victovats/chipalooza3-ldo-gf180/simulations/results/summary.md

# Simulation results (schematic, pre-layout)

Generated by `simulations/run_sims.py`. Typical corner, 27 C, VIN = 5.0 V, VREF = 1.2 V,
EN = 3.3 V (harness logic level), CL = 2 pF, unless noted.

| Parameter | Spec | Simulated | Result | Testbench |
|---|---|---|---|---|
| Output voltage (5 mA) | 3.201 - 3.399 V | 3.3092 V | PASS | tb_load_reg |
| Dropout (10 mA) | <= 300 mV | 152 mV | PASS | tb_dropout |
| Quiescent current (no load) | <= 100 uA | 60.0 uA | PASS | tb_iq |
| Line regulation (4.5-5.5 V, 5 mA) | <= 1.0 % | 0.042 % | PASS | tb_line_reg |
| Load regulation (0-10 mA) | <= 1.0 % | 0.269 % | PASS | tb_load_reg |
| PSRR (100 Hz, 5 mA) | >= 40 dB | 59.0 dB | PASS | tb_psrr |
| PSRR (10 kHz / 1 MHz) | - | 43.9 / 5.2 dB | info | tb_psrr |
| Load step 0->10 mA, 1 us | - | -212 / +313 mV | info | tb_tran_load |
| Line step 5.0->4.5 V, 1 us | - | -54 / +52 mV | info | tb_tran_line |
| EN off -> VOUT | 0 V | 0.00 mV | PASS | tb_en |
| EN turn-on time (to 3.2 V) | - | 1.66 us | info | tb_en |
| EN switching threshold | 3.3 V logic | 1.39 / 1.58 V (VIN 4.5 / 5.5) | PASS | tb_en_dc |
| Shutdown current (EN = 0) | - | 0.19 nA | info | tb_iq |
| Test buffer FB_BUF (FB - FB_BUF) | follows FB | 0.442 V (0.763 V below FB = 1.206 V) | info | tb_iq |
| Test buffer EAOUT_BUF (EAOUT - EAOUT_BUF) | follows EAOUT | 2.908 V (1.331 V below EAOUT = 4.239 V) | info | tb_iq |

line regulation load regulation
dropout PSRR
load transient line transient
EN transient EN threshold
quiescent and shutdown current

## Process corners x temperature (VIN = 5.0 V)

MOS corners tt/ff/ss/fs/sf x poly-resistor and MIM-capacitor corners typical/ff/ss x -40/27/110 C.
Each column uses the same testbench and load as the typical table above: VOUT at a 5 mA ideal current
sink (tb_load_reg), Iq and off current with no load (tb_iq), line reg at 5 mA, load reg 0-10 mA,
dropout at 10 mA, PSRR at 5 mA.

| MOS corner | R/C corner | Temp (C) | VOUT @5 mA (V) | Iq (uA) | Line reg (%) | Load reg (%) | Dropout @10 mA (mV) | PSRR @100 Hz (dB) | Off current, EN = 0 (nA) |
|---|---|---|---|---|---|---|---|---|---|
| typical | typical | -40 | 3.3086  | 55.3  | 0.033  | 0.207  | 107  | 61.1  | 0.18 |
| typical | typical | 27 | 3.3092  | 60.0  | 0.042  | 0.269  | 152  | 59.0  | 0.19 |
| typical | typical | 110 | 3.3097  | 65.0  | 0.050  | 0.378  | 207  | 57.2  | 0.39 |
| typical | ff | -40 | 3.3089  | 67.8  | 0.039  | 0.215  | 107  | 59.6  | 0.18 |
| typical | ff | 27 | 3.3099  | 73.6  | 0.048  | 0.285  | 152  | 57.6  | 0.19 |
| typical | ff | 110 | 3.3108  | 79.7  | 0.057  | 0.420  | 206  | 56.0  | 0.39 |
| typical | ss | -40 | 3.3084  | 46.9  | 0.029  | 0.202  | 108  | 62.5  | 0.18 |
| typical | ss | 27 | 3.3087  | 50.9  | 0.037  | 0.260  | 153  | 60.2  | 0.19 |
| typical | ss | 110 | 3.3090  | 55.1  | 0.045  | 0.354  | 208  | 58.4  | 0.39 |
| ff | typical | -40 | 3.3080  | 60.7  | 0.045  | 0.203  | 83  | 58.2  | 0.20 |
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
| sf | ss | -40 | 3.3078  | 45.3  | 0.048  | 0.206  | 88  | 57.8  | 0.19 |
| sf | ss | 27 | 3.3081  | 48.9  | 0.058  | 0.270  | 123  | 56.0  | 0.19 |
| sf | ss | 110 | 3.3083  | 52.8  | 0.070  | 0.393  | 168  | 54.4  | 0.82 |
