victovats/chipalooza3-ldo-gf180/simulations/results_v2_pex_rc/stability.md

# Regulation-loop stability (post-layout, extracted RC netlist)

Generated by `simulations/stability.py`. Loop broken at the MIN1 gate; T = -v(FB)/v(FBG).
Swept: load 0-10 mA, MOS corners tt/ff/ss/fs/sf, -40/27/110 C, output capacitance 2 pF and 50 pF.

| CL | worst-case PM | at | lowest UGF | highest UGF | min GM |
|---|---|---|---|---|---|
| 2 pF | 64.4 deg | fs, 110 C, 0 mA | 1.27 MHz | 1.88 MHz | 12.6 dB |
| 50 pF | 26.1 deg | fs, 110 C, 0 mA | 0.75 MHz | 1.88 MHz | 10.7 dB |

Typical corner, 27 C:

| Load | CL | T(dc) | UGF | PM | GM |
|---|---|---|---|---|---|
| 0 mA | 2 pF | 69.0 dB | 1.53 MHz | 67.6 deg | 13.6 dB |
| 0.001 mA | 2 pF | 69.5 dB | 1.53 MHz | 68.6 deg | 14.2 dB |
| 0.01 mA | 2 pF | 72.0 dB | 1.55 MHz | 74.0 deg | 17.2 dB |
| 0.1 mA | 2 pF | 76.7 dB | 1.57 MHz | 80.8 deg | 25.7 dB |
| 1 mA | 2 pF | 77.1 dB | 1.56 MHz | 82.5 deg | 36.2 dB |
| 5 mA | 2 pF | 74.8 dB | 1.54 MHz | 83.0 deg | inf dB |
| 10 mA | 2 pF | 74.3 dB | 1.52 MHz | 83.5 deg | inf dB |
| 0 mA | 50 pF | 69.0 dB | 0.90 MHz | 28.7 deg | 12.2 dB |
| 0.001 mA | 50 pF | 69.5 dB | 0.93 MHz | 29.9 deg | 12.6 dB |
| 0.01 mA | 50 pF | 72.0 dB | 1.11 MHz | 38.5 deg | 13.6 dB |
| 0.1 mA | 50 pF | 76.7 dB | 1.49 MHz | 64.5 deg | 17.5 dB |
| 1 mA | 50 pF | 77.1 dB | 1.56 MHz | 78.0 deg | 22.3 dB |
| 5 mA | 50 pF | 74.8 dB | 1.54 MHz | 80.7 deg | 25.4 dB |
| 10 mA | 50 pF | 74.3 dB | 1.52 MHz | 81.8 deg | 28.7 dB |

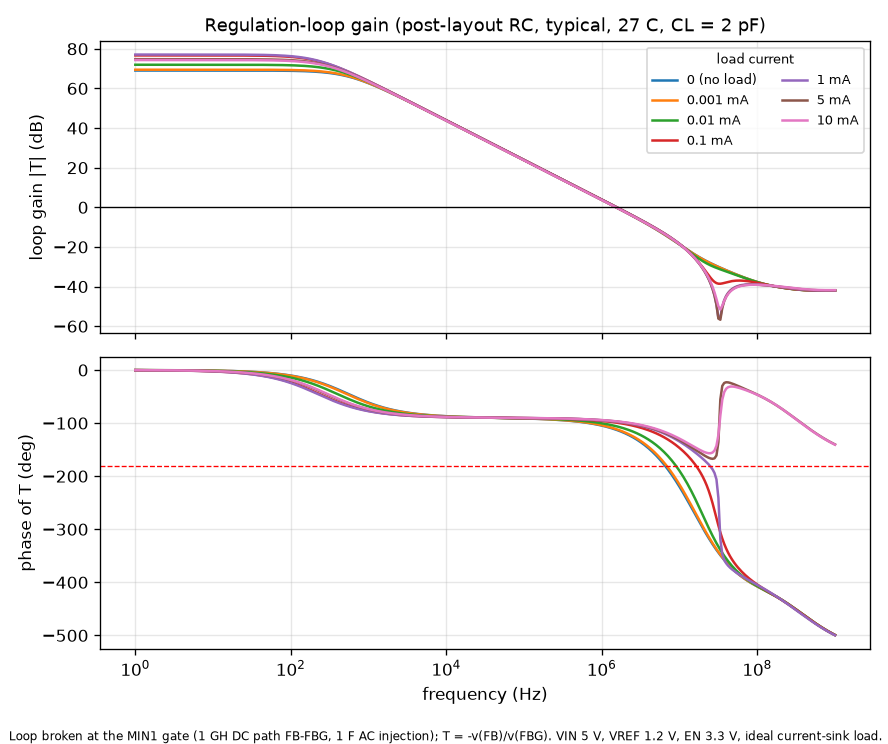
[picture p53: simulations/results_v2_pex_rc/stability.png]
loop gain
