victovats/chipalooza3-ldo-gf180/simulations/results_v2_pex_rc/summary.md

# Simulation results (post-layout, extracted RC netlist)

Generated by `simulations/run_sims.py`. Typical corner, 27 C, VIN = 5.0 V, VREF = 1.2 V,
EN = 3.3 V (harness logic level), CL = 2 pF, unless noted.

| Parameter | Spec | Simulated | Result | Testbench |
|---|---|---|---|---|
| Output voltage (5 mA) | 3.201 - 3.399 V | 3.3093 V | PASS | tb_load_reg |
| Dropout (10 mA) | <= 300 mV | 162 mV | PASS | tb_dropout |
| Quiescent current (no load) | <= 100 uA | 59.8 uA | PASS | tb_iq |
| Line regulation (4.5-5.5 V, 5 mA) | <= 1.0 % | 0.042 % | PASS | tb_line_reg |
| Load regulation (0-10 mA) | <= 1.0 % | 0.271 % | PASS | tb_load_reg |
| PSRR (100 Hz, 5 mA) | >= 40 dB | 59.0 dB | PASS | tb_psrr |
| PSRR (10 kHz / 1 MHz) | - | 43.4 / 4.5 dB | info | tb_psrr |
| Load step 0->10 mA, 1 us | - | -249 / +343 mV | info | tb_tran_load |
| Line step 5.0->4.5 V, 1 us | - | -58 / +56 mV | info | tb_tran_line |
| EN off -> VOUT | 0 V | 0.00 mV | PASS | tb_en |
| EN turn-on time (to 3.2 V) | - | 1.74 us | info | tb_en |
| EN switching threshold | 3.3 V logic | 1.39 / 1.59 V (VIN 4.5 / 5.5) | PASS | tb_en_dc |
| Shutdown current (EN = 0) | - | 1.27 nA | info | tb_iq |
| Test buffer FB_BUF (FB - FB_BUF) | follows FB | 0.442 V (0.764 V below FB = 1.206 V) | info | tb_iq |
| Test buffer EAOUT_BUF (EAOUT - EAOUT_BUF) | follows EAOUT | 2.908 V (1.331 V below EAOUT = 4.239 V) | info | tb_iq |

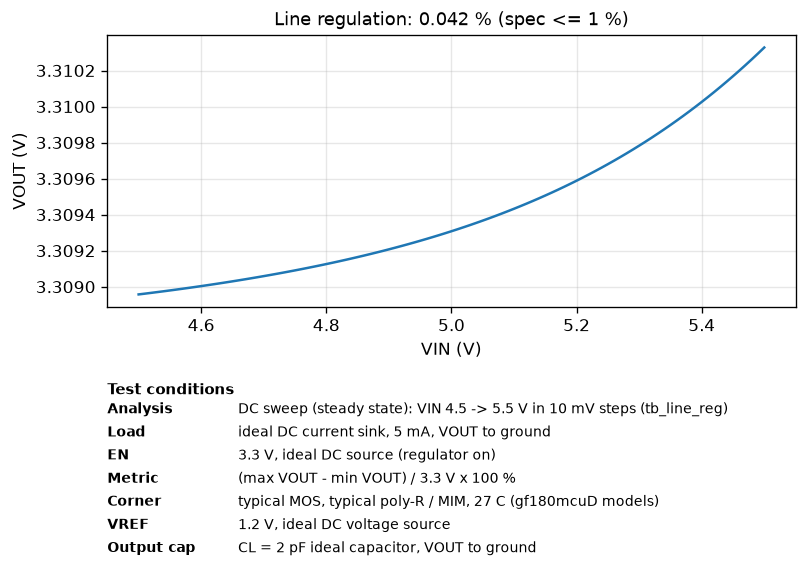
[picture p54: simulations/results_v2_pex_rc/line_reg.png]
line regulation
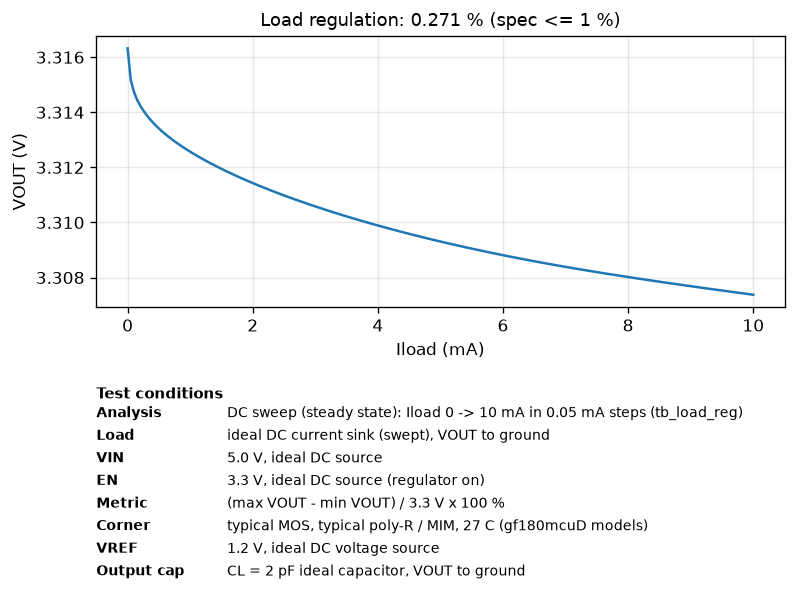
[picture p55: simulations/results_v2_pex_rc/load_reg.png]
load regulation
 
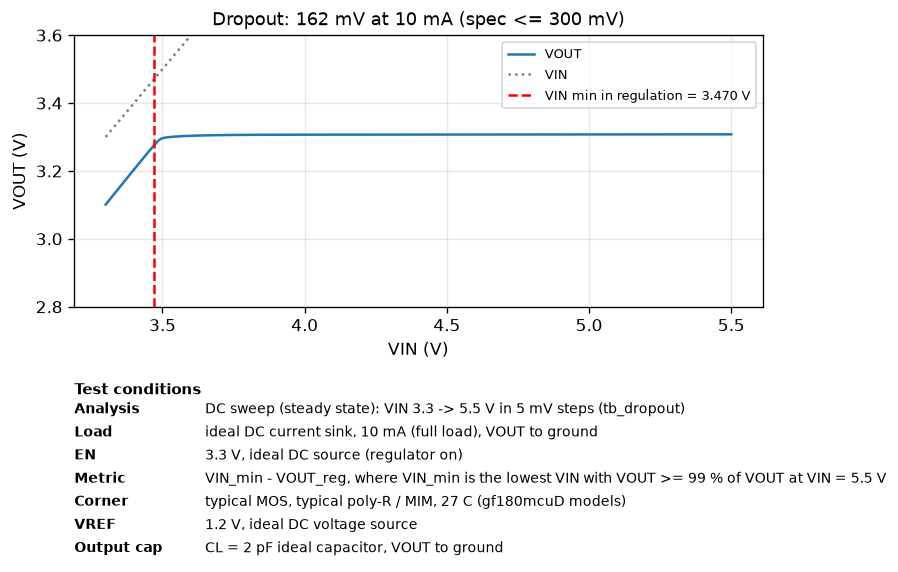
[picture p56: simulations/results_v2_pex_rc/dropout.png]
dropout
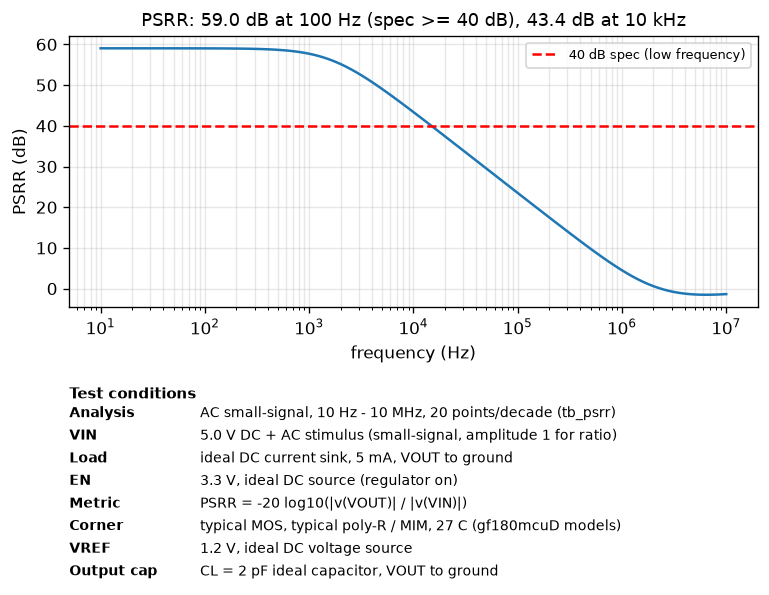
[picture p57: simulations/results_v2_pex_rc/psrr.png]
PSRR
 
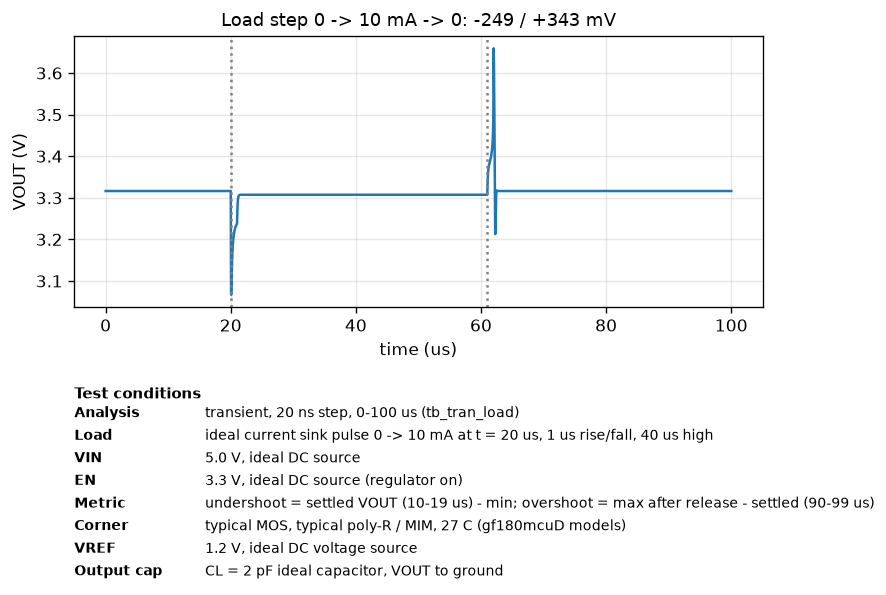
[picture p58: simulations/results_v2_pex_rc/tran_load.png]
load transient
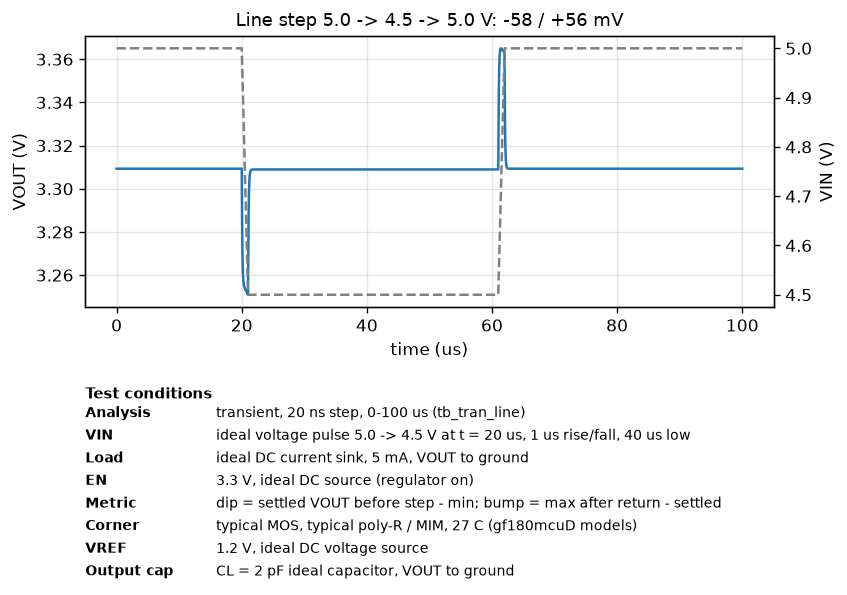
[picture p59: simulations/results_v2_pex_rc/tran_line.png]
line transient
 
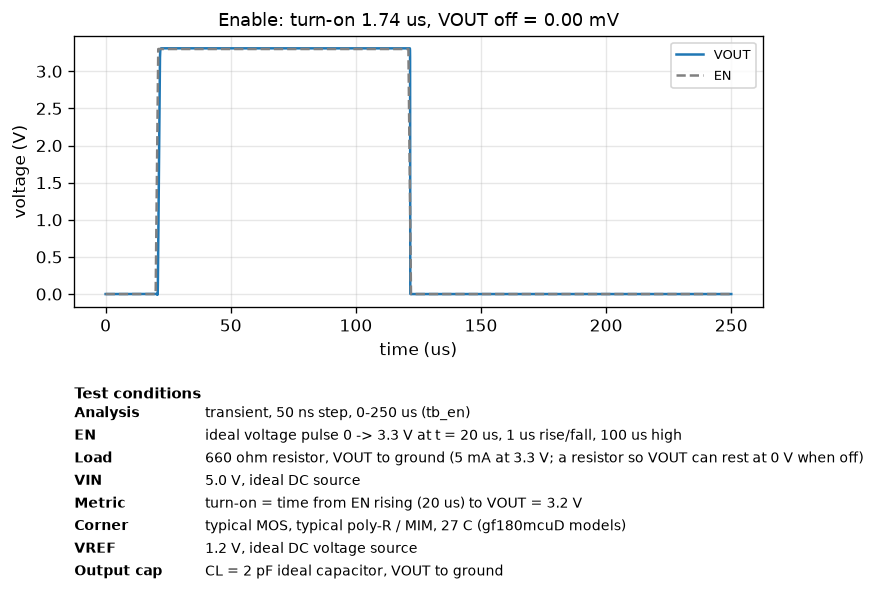
[picture p60: simulations/results_v2_pex_rc/en.png]
EN transient
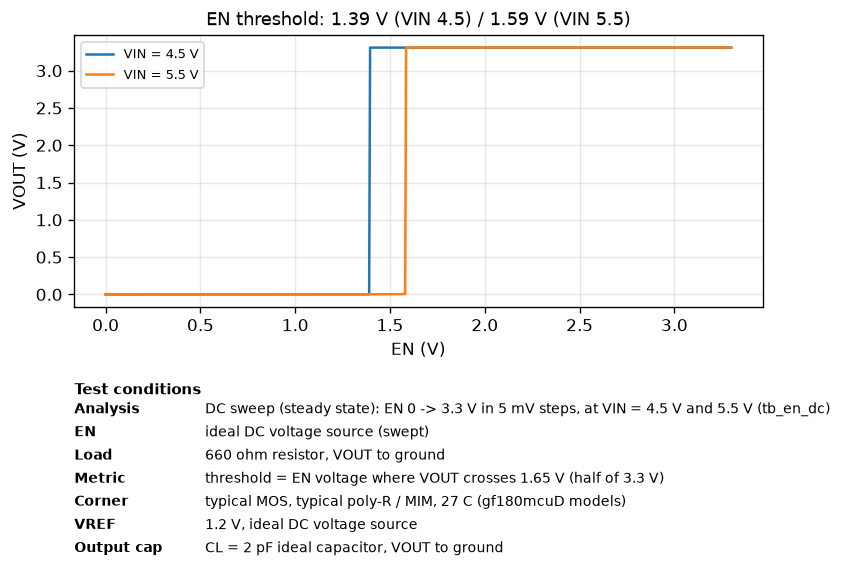
[picture p61: simulations/results_v2_pex_rc/en_dc.png]
EN threshold
 
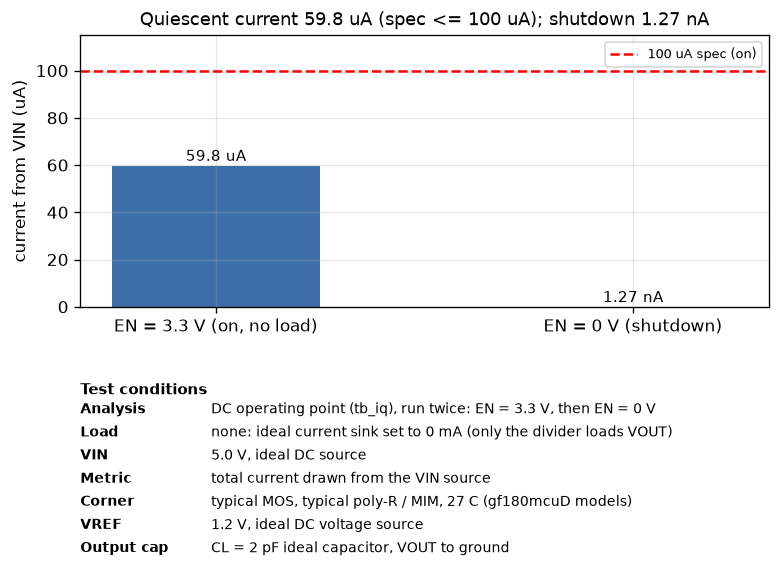
[picture p62: simulations/results_v2_pex_rc/iq.png]
quiescent and shutdown current


## Process corners x temperature (VIN = 5.0 V)

MOS corners tt/ff/ss/fs/sf x poly-resistor and MIM-capacitor corners typical/ff/ss x -40/27/110 C.
Each column uses the same testbench and load as the typical table above: VOUT at a 5 mA ideal current
sink (tb_load_reg), Iq and off current with no load (tb_iq), line reg at 5 mA, load reg 0-10 mA,
dropout at 10 mA, PSRR at 5 mA.

| MOS corner | R/C corner | Temp (C) | VOUT @5 mA (V) | Iq (uA) | Line reg (%) | Load reg (%) | Dropout @10 mA (mV) | PSRR @100 Hz (dB) | Off current, EN = 0 (nA) |
|---|---|---|---|---|---|---|---|---|---|
| typical | typical | -40 | 3.3092  | 55.0  | 0.033  | 0.208  | 117  | 61.2  | 1.27 |
| typical | typical | 27 | 3.3093  | 59.8  | 0.042  | 0.271  | 162  | 59.0  | 1.27 |
| typical | typical | 110 | 3.3097  | 64.8  | 0.050  | 0.382  | 217  | 57.3  | 1.50 |
| typical | ff | -40 | 3.3098  | 67.4  | 0.039  | 0.216  | 121  | 59.7  | 1.27 |
| typical | ff | 27 | 3.3103  | 73.3  | 0.048  | 0.287  | 166  | 57.7  | 1.27 |
| typical | ff | 110 | 3.3110  | 79.3  | 0.057  | 0.427  | 216  | 56.0  | 1.50 |
| typical | ss | -40 | 3.3087  | 46.7  | 0.029  | 0.203  | 117  | 62.5  | 1.27 |
| typical | ss | 27 | 3.3087  | 50.7  | 0.037  | 0.261  | 163  | 60.2  | 1.27 |
| typical | ss | 110 | 3.3088  | 54.9  | 0.044  | 0.357  | 218  | 58.4  | 1.50 |
| ff | typical | -40 | 3.3085  | 60.5  | 0.045  | 0.204  | 97  | 58.4  | 1.29 |
| ff | typical | 27 | 3.3088  | 65.6  | 0.056  | 0.277  | 132  | 56.4  | 1.31 |
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
| sf | ss | -40 | 3.3081  | 45.1  | 0.047  | 0.207  | 98  | 57.9  | 1.28 |
| sf | ss | 27 | 3.3080  | 48.7  | 0.058  | 0.271  | 138  | 56.1  | 1.28 |
| sf | ss | 110 | 3.3081  | 52.6  | 0.069  | 0.396  | 183  | 54.5  | 1.92 |
