victovats/chipalooza3-ldo-gf180/layout/lvs/ldo_v2_lvs.spice

.subckt ldo_v2 VIN VREF EN VOUT FB_BUF EAOUT_BUF VSS
X0 VIN EAOUT EAOUT_BUF VSS nfet_05v0 ad=3p pd=11.2u as=3p ps=11.2u w=5u l=0.6u
X1 VOUT EAOUT VIN VIN pfet_06v0 ad=0.84p pd=3.56u as=0.84p ps=3.56u w=3u l=0.55u
X2 VOUT EAOUT VIN VIN pfet_06v0 ad=0.84p pd=3.56u as=0.84p ps=3.56u w=3u l=0.55u
X3 VOUT EAOUT VIN VIN pfet_06v0 ad=0.84p pd=3.56u as=0.84p ps=3.56u w=3u l=0.55u
X4 VIN EAOUT VOUT VIN pfet_06v0 ad=0.84p pd=3.56u as=0.84p ps=3.56u w=3u l=0.55u
X5 VIN EAOUT VOUT VIN pfet_06v0 ad=0.84p pd=3.56u as=0.84p ps=3.56u w=3u l=0.55u
X6 VIN EAOUT VOUT VIN pfet_06v0 ad=0.84p pd=3.56u as=0.84p ps=3.56u w=3u l=0.55u
X7 VOUT EAOUT VIN VIN pfet_06v0 ad=0.84p pd=3.56u as=0.84p ps=3.56u w=3u l=0.55u
X8 VOUT EAOUT VIN VIN pfet_06v0 ad=0.84p pd=3.56u as=0.84p ps=3.56u w=3u l=0.55u
X9 VOUT EAOUT VIN VIN pfet_06v0 ad=0.84p pd=3.56u as=0.84p ps=3.56u w=3u l=0.55u
X10 VIN EAOUT VOUT VIN pfet_06v0 ad=0.84p pd=3.56u as=0.84p ps=3.56u w=3u l=0.55u
X11 VIN EAOUT VOUT VIN pfet_06v0 ad=0.84p pd=3.56u as=0.84p ps=3.56u w=3u l=0.55u
X12 VIN EAOUT VOUT VIN pfet_06v0 ad=0.84p pd=3.56u as=0.84p ps=3.56u w=3u l=0.55u
X13 VIN EAOUT VOUT VIN pfet_06v0 ad=0.84p pd=3.56u as=0.84p ps=3.56u w=3u l=0.55u
X14 VOUT EAOUT VIN VIN pfet_06v0 ad=0.84p pd=3.56u as=0.84p ps=3.56u w=3u l=0.55u
X15 VOUT EAOUT VIN VIN pfet_06v0 ad=0.84p pd=3.56u as=0.84p ps=3.56u w=3u l=0.55u
X16 VIN EAOUT VOUT VIN pfet_06v0 ad=0.84p pd=3.56u as=0.84p ps=3.56u w=3u l=0.55u
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
X213 v2_nmos_core/a_n768_3216# VREF EAOUT VSS nfet_06v0 ad=1.4p pd=5.56u as=1.4p ps=5.56u w=5u l=3u
X214 EAOUT VREF v2_nmos_core/a_n768_3216# VSS nfet_06v0 ad=1.4p pd=5.56u as=1.4p ps=5.56u w=5u l=3u
X216 EAOUT VREF v2_nmos_core/a_n768_3216# VSS nfet_06v0 ad=1.4p pd=5.56u as=1.4p ps=5.56u w=5u l=3u
X217 VSS IREF v2_nmos_core/a_n768_3216# VSS nfet_05v0 ad=0.35p pd=1.81u as=0.35p ps=1.81u w=1.25u l=0.6u
X218 v2_nmos_core/a_n768_3216# IREF VSS VSS nfet_05v0 ad=0.35p pd=1.81u as=0.35p ps=1.81u w=1.25u l=0.6u
X219 v2_nmos_core/a_n768_3216# FB v2_pmos_core/EAREF VSS nfet_06v0 ad=1.4p pd=5.56u as=1.4p ps=5.56u w=5u l=3u
X220 IREF IREF VSS VSS nfet_05v0 ad=0.35p pd=1.81u as=0.35p ps=1.81u w=1.25u l=0.6u
X221 v2_pmos_core/EAREF FB v2_nmos_core/a_n768_3216# VSS nfet_06v0 ad=1.4p pd=5.56u as=1.4p ps=5.56u w=5u l=3u
X222 VSS IREF IREF VSS nfet_05v0 ad=0.35p pd=1.81u as=0.35p ps=1.81u w=1.25u l=0.6u
X225 VSS EN v2_pmos_core/ENB_5V VSS nfet_06v0 ad=0.3p pd=2.2u as=0.3p ps=2.2u w=0.5u l=5u
X226 VSS IREF v2_nmos_core/a_n768_3216# VSS nfet_05v0 ad=0.35p pd=1.81u as=0.35p ps=1.81u w=1.25u l=0.6u
X227 VSS IREF IREF VSS nfet_05v0 ad=0.35p pd=1.81u as=0.35p ps=1.81u w=1.25u l=0.6u
X231 v2_nmos_core/a_n768_3216# FB v2_pmos_core/EAREF VSS nfet_06v0 ad=1.4p pd=5.56u as=1.4p ps=5.56u w=5u l=3u
X234 VSS v2_pmos_core/ENB_5V VOUT VSS nfet_05v0 ad=3p pd=11.2u as=3p ps=11.2u w=5u l=0.6u
X237 IREF IREF VSS VSS nfet_05v0 ad=0.35p pd=1.81u as=0.35p ps=1.81u w=1.25u l=0.6u
X238 v2_nmos_core/a_n768_3216# IREF VSS VSS nfet_05v0 ad=0.35p pd=1.81u as=0.35p ps=1.81u w=1.25u l=0.6u
X239 v2_pmos_core/EAREF FB v2_nmos_core/a_n768_3216# VSS nfet_06v0 ad=1.4p pd=5.56u as=1.4p ps=5.56u w=5u l=3u
X242 v2_nmos_core/a_n768_3216# VREF EAOUT VSS nfet_06v0 ad=1.4p pd=5.56u as=1.4p ps=5.56u w=5u l=3u
X243 R1R2/m1_n2438_4985# R1R2/m1_n1958_n5053# VSS ppolyf_u_1k_6p0 r_width=2u r_length=49.33u
X244 R1R2/m1_n998_4985# R1R2/m1_n38_n5053# VSS ppolyf_u_1k_6p0 r_width=2u r_length=49.33u
X245 R1R2/m1_n1478_4985# R1R2/m1_n518_n5053# VSS ppolyf_u_1k_6p0 r_width=2u r_length=49.33u
X246 R1R2/m1_n998_4985# R1R2/m1_n1958_n5053# VSS ppolyf_u_1k_6p0 r_width=2u r_length=49.33u
X247 R1R2/m1_n1478_4985# VSS VSS ppolyf_u_1k_6p0 r_width=2u r_length=49.33u
X250 R1R2/m1_n2438_4985# FB VSS ppolyf_u_1k_6p0 r_width=2u r_length=49.33u
X251 VOUT R1R2/m1_1882_n5053# VSS ppolyf_u_1k_6p0 r_width=2u r_length=49.33u
X252 R1R2/m1_442_4985# FB VSS ppolyf_u_1k_6p0 r_width=2u r_length=49.33u
X253 R1R2/m1_922_4985# R1R2/m1_1882_n5053# VSS ppolyf_u_1k_6p0 r_width=2u r_length=49.33u
X254 R1R2/m1_442_4985# R1R2/m1_n518_n5053# VSS ppolyf_u_1k_6p0 r_width=2u r_length=49.33u
X255 R1R2/m1_922_4985# R1R2/m1_n38_n5053# VSS ppolyf_u_1k_6p0 r_width=2u r_length=49.33u
X256 VIN_BIAS m1_704_5244# VSS ppolyf_u_1k_6p0 r_width=1u r_length=1.94384m
X257 m1_704_5244# v2_pmos_core/ENB_5V VSS VSS nfet_05v0 ad=0.6p pd=3.2u as=0.6p ps=3.2u w=1u l=0.6u
X258 v2_pmos_core/a_n2200_394# v2_pmos_core/EAREF v2_pmos_core/EAREF VIN pfet_06v0 ad=0.35p pd=1.81u as=0.35p ps=1.81u w=1.25u l=0.55u
X260 VIN VSS v2_pmos_core/ENB_5V VIN pfet_06v0 ad=0.6p pd=3.2u as=0.6p ps=3.2u w=1u l=40u
X262 v2_pmos_core/a_n2200_1734# v2_pmos_core/EAREF EAOUT VIN pfet_06v0 ad=0.35p pd=1.81u as=0.35p ps=1.81u w=1.25u l=0.55u
X263 v2_pmos_core/a_n2200_1734# v2_pmos_core/a_n2200_394# VIN VIN pfet_06v0 ad=0.7p pd=3.06u as=0.7p ps=3.06u w=2.5u l=3u
X264 v2_pmos_core/a_n2200_394# v2_pmos_core/a_n2200_394# VIN VIN pfet_06v0 ad=0.7p pd=3.06u as=0.7p ps=3.06u w=2.5u l=3u
X265 VIN v2_pmos_core/a_n2200_394# v2_pmos_core/a_n2200_394# VIN pfet_06v0 ad=0.7p pd=3.06u as=0.7p ps=3.06u w=2.5u l=3u
X267 v2_pmos_core/a_n2200_1734# v2_pmos_core/a_n2200_394# VIN VIN pfet_06v0 ad=0.7p pd=3.06u as=0.7p ps=3.06u w=2.5u l=3u
X268 VIN v2_pmos_core/a_n2200_394# v2_pmos_core/a_n2200_394# VIN pfet_06v0 ad=0.7p pd=3.06u as=0.7p ps=3.06u w=2.5u l=3u
X269 v2_pmos_core/a_n2200_1734# v2_pmos_core/EAREF EAOUT VIN pfet_06v0 ad=0.35p pd=1.81u as=0.35p ps=1.81u w=1.25u l=0.55u
X270 v2_pmos_core/EAREF v2_pmos_core/EAREF v2_pmos_core/a_n2200_394# VIN pfet_06v0 ad=0.35p pd=1.81u as=0.35p ps=1.81u w=1.25u l=0.55u
X271 VIN v2_pmos_core/EN_5V EAOUT VIN pfet_06v0 ad=3p pd=11.2u as=3p ps=11.2u w=5u l=0.6u
X272 v2_pmos_core/a_n2200_394# v2_pmos_core/a_n2200_394# VIN VIN pfet_06v0 ad=0.7p pd=3.06u as=0.7p ps=3.06u w=2.5u l=3u
X273 EAOUT v2_pmos_core/EAREF v2_pmos_core/a_n2200_1734# VIN pfet_06v0 ad=0.35p pd=1.81u as=0.35p ps=1.81u w=1.25u l=0.55u
X277 VIN_BIAS v2_pmos_core/ENB_5V VIN VIN pfet_06v0 ad=1.4p pd=5.56u as=3p ps=11.2u w=5u l=0.6u
X278 VIN v2_pmos_core/a_n2200_394# v2_pmos_core/a_n2200_1734# VIN pfet_06v0 ad=0.7p pd=3.06u as=0.7p ps=3.06u w=2.5u l=3u
X279 v2_pmos_core/EAREF v2_pmos_core/EAREF v2_pmos_core/a_n2200_394# VIN pfet_06v0 ad=0.35p pd=1.81u as=0.35p ps=1.81u w=1.25u l=0.55u
X281 VIN v2_pmos_core/ENB_5V v2_pmos_core/EN_5V VIN pfet_06v0 ad=3p pd=11.2u as=3p ps=11.2u w=5u l=0.6u
X285 EAOUT v2_pmos_core/EAREF v2_pmos_core/a_n2200_1734# VIN pfet_06v0 ad=0.35p pd=1.81u as=0.35p ps=1.81u w=1.25u l=0.55u
X288 VIN v2_pmos_core/ENB_5V VIN_BIAS VIN pfet_06v0 ad=3p pd=11.2u as=1.4p ps=5.56u w=5u l=0.6u
X290 VIN v2_pmos_core/a_n2200_394# v2_pmos_core/a_n2200_1734# VIN pfet_06v0 ad=0.7p pd=3.06u as=0.7p ps=3.06u w=2.5u l=3u
X291 v2_pmos_core/a_n2200_394# v2_pmos_core/EAREF v2_pmos_core/EAREF VIN pfet_06v0 ad=0.35p pd=1.81u as=0.35p ps=1.81u w=1.25u l=0.55u
X294 EAOUT_BUF m1_704_5244# VSS VSS nfet_05v0 ad=1.5p pd=6.2u as=1.5p ps=6.2u w=2.5u l=0.6u
X295 m1_704_5244# m1_704_5244# VSS VSS nfet_05v0 ad=1.5p pd=6.2u as=1.5p ps=6.2u w=2.5u l=0.6u
X296 EAOUT_BUF m1_704_5244# VSS VSS nfet_05v0 ad=1.5p pd=6.2u as=1.5p ps=6.2u w=2.5u l=0.6u
X298 FB_BUF m1_704_5244# VSS VSS nfet_05v0 ad=1.5p pd=6.2u as=1.5p ps=6.2u w=2.5u l=0.6u
X299 m1_704_5244# m1_704_5244# VSS VSS nfet_05v0 ad=1.5p pd=6.2u as=1.5p ps=6.2u w=2.5u l=0.6u
X300 FB_BUF m1_704_5244# VSS VSS nfet_05v0 ad=1.5p pd=6.2u as=1.5p ps=6.2u w=2.5u l=0.6u
X301 VIN_BIAS IREF VSS ppolyf_u_1k_6p0 r_width=1u r_length=0.19609m
X302 VIN FB FB_BUF VSS nfet_05v0 ad=0.18974n pd=0.9822m as=6p ps=23.6u w=5u l=0.6u
X303 EAOUT VOUT cap_mim_2f0_m4m5_noshield c_width=27.35u c_length=54.5u
.ends
