victovats/chipalooza3-ldo-gf180/layout/lvs/v2_nmos_core_lay_lvs.spice

.subckt v2_nmos_core EAOUT EAREF EN ENB_5V EN_5V FB IREF VOUT VREF VSS
X0 VSS ENB_5V IREF VSS nfet_05v0 ad=0.6p pd=3.2u as=0.6p ps=3.2u w=1u l=0.6u
X1 VSS ENB_5V EN_5V VSS nfet_05v0 ad=3p pd=11.2u as=3p ps=11.2u w=5u l=0.6u
X2 a_n768_3216# VREF EAOUT VSS nfet_06v0 ad=1.4p pd=5.56u as=1.4p ps=5.56u w=5u l=3u
X3 EAOUT VREF a_n768_3216# VSS nfet_06v0 ad=1.4p pd=5.56u as=1.4p ps=5.56u w=5u l=3u
X5 EAOUT VREF a_n768_3216# VSS nfet_06v0 ad=1.4p pd=5.56u as=1.4p ps=5.56u w=5u l=3u
X6 VSS IREF a_n768_3216# VSS nfet_05v0 ad=0.35p pd=1.81u as=0.35p ps=1.81u w=1.25u l=0.6u
X7 a_n768_3216# IREF VSS VSS nfet_05v0 ad=0.35p pd=1.81u as=0.35p ps=1.81u w=1.25u l=0.6u
X8 a_n768_3216# FB EAREF VSS nfet_06v0 ad=1.4p pd=5.56u as=1.4p ps=5.56u w=5u l=3u
X9 IREF IREF VSS VSS nfet_05v0 ad=0.35p pd=1.81u as=0.35p ps=1.81u w=1.25u l=0.6u
X10 EAREF FB a_n768_3216# VSS nfet_06v0 ad=1.4p pd=5.56u as=1.4p ps=5.56u w=5u l=3u
X11 VSS IREF IREF VSS nfet_05v0 ad=0.35p pd=1.81u as=0.35p ps=1.81u w=1.25u l=0.6u
X14 VSS EN ENB_5V VSS nfet_06v0 ad=0.3p pd=2.2u as=0.3p ps=2.2u w=0.5u l=5u
X15 VSS IREF a_n768_3216# VSS nfet_05v0 ad=0.35p pd=1.81u as=0.35p ps=1.81u w=1.25u l=0.6u
X16 VSS IREF IREF VSS nfet_05v0 ad=0.35p pd=1.81u as=0.35p ps=1.81u w=1.25u l=0.6u
X20 a_n768_3216# FB EAREF VSS nfet_06v0 ad=1.4p pd=5.56u as=1.4p ps=5.56u w=5u l=3u
X23 VSS ENB_5V VOUT VSS nfet_05v0 ad=3p pd=11.2u as=3p ps=11.2u w=5u l=0.6u
X26 IREF IREF VSS VSS nfet_05v0 ad=0.35p pd=1.81u as=0.35p ps=1.81u w=1.25u l=0.6u
X27 a_n768_3216# IREF VSS VSS nfet_05v0 ad=0.35p pd=1.81u as=0.35p ps=1.81u w=1.25u l=0.6u
X28 EAREF FB a_n768_3216# VSS nfet_06v0 ad=1.4p pd=5.56u as=1.4p ps=5.56u w=5u l=3u
X31 a_n768_3216# VREF EAOUT VSS nfet_06v0 ad=1.4p pd=5.56u as=1.4p ps=5.56u w=5u l=3u
.ends
