victovats/chipalooza3-ldo-gf180/layout/pex/emir_op.spice

* EM/IR operating point: RC-extracted v2 LDO at full load
.include /foss/pdks/gf180mcuD/libs.tech/ngspice/design.ngspice
.lib /foss/pdks/gf180mcuD/libs.tech/ngspice/sm141064.ngspice typical
.lib /foss/pdks/gf180mcuD/libs.tech/ngspice/sm141064.ngspice res_typical
.lib /foss/pdks/gf180mcuD/libs.tech/ngspice/sm141064.ngspice cap_mim
.lib /foss/pdks/gf180mcuD/libs.tech/ngspice/sm141064.ngspice mimcap_typical
.include ldo_pex_rc.spice
x1 EAOUT_BUF FB_BUF EN VREF VIN VOUT VSS ldo_flat
Vvin VIN 0 5
Vvss VSS 0 0
Vvref VREF 0 1.2
Ven EN 0 3.3
Iload VOUT 0 0.01
.control
op
print all > emir_op.txt
print i(vvin) i(vvss) > emir_i.txt
.endc
.end
