victovats/chipalooza3-ldo-gf180/layout/pex/ldo_pex_rc.spice

* NGSPICE file created from ldo_flat.ext - technology: gf180mcuD

.subckt ldo_flat EAOUT_BUF FB_BUF EN VREF VIN VOUT VSS
X0 VIN.t303 EAOUT.t45 VOUT.t173 VIN.t183 pfet_06v0 ad=0.84p pd=3.56u as=0.84p ps=3.56u w=3u l=0.55u
X1 VOUT.t31 EAOUT.t116 VIN.t68 VIN.t45 pfet_06v0 ad=0.84p pd=3.56u as=0.84p ps=3.56u w=3u l=0.55u
X2 VIN.t259 EAOUT.t83 VOUT.t135 VIN.t127 pfet_06v0 ad=0.84p pd=3.56u as=0.84p ps=3.56u w=3u l=0.55u
X3 a_22144_9605.t0 a_22144_8265.t18 VIN.t23 VIN.t22 pfet_06v0 ad=0.7p pd=3.06u as=0.7p ps=3.06u w=2.5u l=3u
X4 VIN.t284 EAOUT.t123 VOUT.t155 VIN.t173 pfet_06v0 ad=0.84p pd=3.56u as=0.84p ps=3.56u w=3u l=0.55u
X5 VIN.t289 EAOUT.t103 VOUT.t160 VIN.t2 pfet_06v0 ad=0.84p pd=3.56u as=0.84p ps=3.56u w=3u l=0.55u
X6 VOUT.t179 EAOUT.t96 VIN.t309 VIN.t41 pfet_06v0 ad=0.84p pd=3.56u as=0.84p ps=3.56u w=3u l=0.55u
X7 VOUT.t12 a_16652_8722# VSS.t65 ppolyf_u_1k_6p0 r_width=2u r_length=49.33u
X8 VIN.t212 EAOUT.t219 VOUT.t124 VIN.t83 pfet_06v0 ad=0.84p pd=3.56u as=0.84p ps=3.56u w=3u l=0.55u
X9 VOUT.t76 EAOUT.t212 VIN.t148 VIN.t89 pfet_06v0 ad=0.84p pd=3.56u as=0.84p ps=3.56u w=3u l=0.55u
X10 VIN.t205 EAOUT.t165 VOUT.t117 VIN.t10 pfet_06v0 ad=0.84p pd=3.56u as=0.84p ps=3.56u w=3u l=0.55u
X11 VOUT.t177 EAOUT.t158 VIN.t307 VIN.t8 pfet_06v0 ad=0.84p pd=3.56u as=0.84p ps=3.56u w=3u l=0.55u
X12 VIN.t343 EAOUT.t135 VOUT.t209 VIN.t98 pfet_06v0 ad=0.84p pd=3.56u as=0.84p ps=3.56u w=3u l=0.55u
X13 VOUT.t188 EAOUT.t128 VIN.t318 VIN.t28 pfet_06v0 ad=0.84p pd=3.56u as=0.84p ps=3.56u w=3u l=0.55u
X14 VOUT.t210 EAOUT.t112 VIN.t344 VIN.t102 pfet_06v0 ad=0.84p pd=3.56u as=0.84p ps=3.56u w=3u l=0.55u
X15 a_22144_9605.t9 VIN.t239 a_22144_9605.t8 VIN.t240 pfet_06v0 ad=1.5p pd=6.2u as=0 ps=0 w=2.5u l=3u
X16 VOUT.t201 EAOUT.t196 VIN.t335 VIN.t290 pfet_06v0 ad=0.84p pd=3.56u as=0.84p ps=3.56u w=3u l=0.55u
X17 VOUT.t98 EAOUT.t190 VIN.t180 VIN.t138 pfet_06v0 ad=0.84p pd=3.56u as=0.84p ps=3.56u w=3u l=0.55u
X18 EAOUT.t4 VSS.t26 EAOUT.t3 VSS.t27 nfet_06v0 ad=1.4p pd=5.56u as=0 ps=0 w=5u l=3u
X19 VIN.t254 VIN.t252 VIN.t253 VIN.t244 pfet_06v0 ad=1.45p pd=6.16u as=0 ps=0 w=2.5u l=3u
X20 VOUT.t68 EAOUT.t82 VIN.t140 VIN.t125 pfet_06v0 ad=0.84p pd=3.56u as=0.84p ps=3.56u w=3u l=0.55u
X21 VOUT.t138 EAOUT.t66 VIN.t267 VIN.t162 pfet_06v0 ad=0.84p pd=3.56u as=0.84p ps=3.56u w=3u l=0.55u
X22 VIN.t271 EAOUT.t35 VOUT.t142 VIN.t197 pfet_06v0 ad=0.84p pd=3.56u as=0.84p ps=3.56u w=3u l=0.55u
X23 VOUT.t29 EAOUT.t28 VIN.t62 VIN.t61 pfet_06v0 ad=0.84p pd=3.56u as=0.84p ps=3.56u w=3u l=0.55u
X24 a_23576_3894.t3 VREF.t3 EAOUT.t5 VSS.t58 nfet_06v0 ad=1.4p pd=5.56u as=1.4p ps=5.56u w=5u l=3u
X25 VSS.t92 IREF.t12 a_23576_3894.t9 VSS.t91 nfet_05v0 ad=0.35p pd=1.81u as=0.35p ps=1.81u w=1.25u l=0.6u
X26 VOUT.t3 EAOUT.t78 VIN.t7 VIN.t6 pfet_06v0 ad=0.84p pd=3.56u as=0.84p ps=3.56u w=3u l=0.55u
X27 VOUT.t30 EAOUT.t44 VIN.t64 VIN.t63 pfet_06v0 ad=0.84p pd=3.56u as=0.84p ps=3.56u w=3u l=0.55u
X28 VIN.t234 VIN.t231 VIN.t233 VIN.t232 pfet_06v0 ad=0.725p pd=3.66u as=0 ps=0 w=1.25u l=0.55u
X29 VIN.t257 EAOUT.t17 VOUT.t134 VIN.t58 pfet_06v0 ad=0.84p pd=3.56u as=0.84p ps=3.56u w=3u l=0.55u
X30 VOUT.t19 EAOUT.t24 VIN.t44 VIN.t43 pfet_06v0 ad=0.84p pd=3.56u as=0.84p ps=3.56u w=3u l=0.55u
X31 VSS.t55 VSS.t52 VSS.t54 VSS.t53 nfet_05v0 ad=0.725p pd=3.66u as=0 ps=0 w=1.25u l=0.6u
X32 VSS.t39 VSS.t37 VSS.t38 VSS.t29 nfet_06v0 ad=2.9p pd=11.16u as=0 ps=0 w=5u l=3u
X33 VIN.t141 EAOUT.t49 VOUT.t69 VIN.t71 pfet_06v0 ad=0.84p pd=3.56u as=0.84p ps=3.56u w=3u l=0.55u
X34 VOUT.t40 EAOUT.t150 VIN.t86 VIN.t85 pfet_06v0 ad=0.84p pd=3.56u as=0.84p ps=3.56u w=3u l=0.55u
X35 VIN.t275 EAOUT.t143 VOUT.t146 VIN.t149 pfet_06v0 ad=0.84p pd=3.56u as=0.84p ps=3.56u w=3u l=0.55u
X36 VIN.t317 EAOUT.t127 VOUT.t187 VIN.t105 pfet_06v0 ad=0.84p pd=3.56u as=0.84p ps=3.56u w=3u l=0.55u
X37 VIN.t121 EAOUT.t89 VOUT.t56 VIN.t120 pfet_06v0 ad=0.84p pd=3.56u as=0.84p ps=3.56u w=3u l=0.55u
X38 v2_pmos_core.EAREF.t9 VIN.t227 a_22144_9605.t12 VIN.t228 pfet_06v0 ad=0.35p pd=1.81u as=0.35p ps=1.81u w=1.25u l=0.55u
X39 VIN.t158 EAOUT.t211 VOUT.t83 VIN.t157 pfet_06v0 ad=0.84p pd=3.56u as=0.84p ps=3.56u w=3u l=0.55u
X40 VOUT.t121 EAOUT.t216 VIN.t209 VIN.t91 pfet_06v0 ad=0.84p pd=3.56u as=0.84p ps=3.56u w=3u l=0.55u
X41 VIN.t200 EAOUT.t169 VOUT.t113 VIN.t24 pfet_06v0 ad=0.84p pd=3.56u as=0.84p ps=3.56u w=3u l=0.55u
X42 VOUT.t170 EAOUT.t162 VIN.t300 VIN.t93 pfet_06v0 ad=0.84p pd=3.56u as=0.84p ps=3.56u w=3u l=0.55u
X43 VIN.t326 EAOUT.t139 VOUT.t195 VIN.t154 pfet_06v0 ad=0.84p pd=3.56u as=0.84p ps=3.56u w=3u l=0.55u
X44 VIN.t40 EAOUT.t85 VOUT.t17 VIN.t39 pfet_06v0 ad=1.8p pd=7.2u as=0.84p ps=3.56u w=3u l=0.55u
X45 VOUT.t128 EAOUT.t110 VIN.t216 VIN.t118 pfet_06v0 ad=0.84p pd=3.56u as=0.84p ps=3.56u w=3u l=0.55u
X46 VOUT.t94 EAOUT.t194 VIN.t176 VIN.t175 pfet_06v0 ad=0.84p pd=3.56u as=0.84p ps=3.56u w=3u l=0.55u
X47 VOUT.t106 EAOUT.t178 VIN.t191 VIN.t12 pfet_06v0 ad=0.84p pd=3.56u as=0.84p ps=3.56u w=3u l=0.55u
X48 VOUT.t147 EAOUT.t32 VIN.t276 VIN.t193 pfet_06v0 ad=0.84p pd=3.56u as=0.84p ps=3.56u w=3u l=0.55u
X49 VOUT.t131 EAOUT.t16 VIN.t255 VIN.t53 pfet_06v0 ad=0.84p pd=3.56u as=0.84p ps=3.56u w=3u l=0.55u
X50 VOUT.t139 EAOUT.t64 VIN.t268 VIN.t159 pfet_06v0 ad=0.84p pd=3.56u as=0.84p ps=3.56u w=3u l=0.55u
X51 VOUT.t16 EAOUT.t48 VIN.t37 VIN.t36 pfet_06v0 ad=0.84p pd=3.56u as=0.84p ps=3.56u w=3u l=0.55u
X52 VIN.t296 EAOUT.t41 VOUT.t166 VIN.t133 pfet_06v0 ad=0.84p pd=3.56u as=0.84p ps=3.56u w=3u l=0.55u
X53 VSS.t31 VSS.t28 VSS.t30 VSS.t29 nfet_06v0 ad=2.9p pd=11.16u as=0 ps=0 w=5u l=3u
X54 v2_pmos_core.EAREF.t11 VIN.t223 v2_pmos_core.EAREF.t10 VIN.t224 pfet_06v0 ad=0.75p pd=3.7u as=0 ps=0 w=1.25u l=0.55u
X55 a_23576_3894.t10 IREF.t11 VSS.t83 VSS.t82 nfet_05v0 ad=0.35p pd=1.81u as=0.35p ps=1.81u w=1.25u l=0.6u
X56 VIN.t80 a_22144_8265.t3 a_22144_8265.t4 VIN.t79 pfet_06v0 ad=0.7p pd=3.06u as=0.7p ps=3.06u w=2.5u l=3u
X57 VIN.t112 EAOUT.t147 VOUT.t53 VIN.t75 pfet_06v0 ad=0.84p pd=3.56u as=0.84p ps=3.56u w=3u l=0.55u
X58 VOUT.t157 EAOUT.t100 VIN.t286 VIN.t15 pfet_06v0 ad=0.84p pd=3.56u as=0.84p ps=3.56u w=3u l=0.55u
X59 VIN.t123 EAOUT.t93 VOUT.t57 VIN.t122 pfet_06v0 ad=0.84p pd=3.56u as=0.84p ps=3.56u w=3u l=0.55u
X60 VOUT.t23 EAOUT.t60 VIN.t52 VIN.t51 pfet_06v0 ad=0.84p pd=3.56u as=0.84p ps=3.56u w=3u l=0.55u
X61 a_15692_18710# a_14732_8722# VSS.t107 ppolyf_u_1k_6p0 r_width=2u r_length=49.33u
X62 VIN.t190 EAOUT.t177 VOUT.t105 VIN.t189 pfet_06v0 ad=0.84p pd=3.56u as=0.84p ps=3.56u w=3u l=0.55u
X63 VIN.t299 EAOUT.t161 VOUT.t169 VIN.t20 pfet_06v0 ad=0.84p pd=3.56u as=0.84p ps=3.56u w=3u l=0.55u
X64 VIN.t322 EAOUT.t131 VOUT.t191 VIN.t114 pfet_06v0 ad=0.84p pd=3.56u as=0.84p ps=3.56u w=3u l=0.55u
X65 VSS.t64 EN.t0 v2_pmos_core.ENB_5V VSS.t63 nfet_06v0 ad=0.3p pd=2.2u as=0.3p ps=2.2u w=0.5u l=5u
X66 VSS.t19 VSS.t16 VSS.t18 VSS.t17 nfet_05v0 ad=1.45p pd=6.16u as=0 ps=0 w=2.5u l=0.6u
X67 EAOUT.t9 v2_pmos_core.EAREF.t25 a_22144_9605.t13 VIN.t333 pfet_06v0 ad=0.35p pd=1.81u as=0.35p ps=1.81u w=1.25u l=0.55u
X68 VIN.t315 EAOUT.t125 VOUT.t185 VIN.t95 pfet_06v0 ad=0.84p pd=3.56u as=0.84p ps=3.56u w=3u l=0.55u
X69 VIN.t174 EAOUT.t193 VOUT.t93 VIN.t173 pfet_06v0 ad=0.84p pd=3.56u as=0.84p ps=3.56u w=3u l=0.55u
X70 VOUT.t102 EAOUT.t186 VIN.t185 VIN.t45 pfet_06v0 ad=0.84p pd=3.56u as=0.84p ps=3.56u w=3u l=0.55u
X71 VOUT.t118 EAOUT.t166 VIN.t206 VIN.t41 pfet_06v0 ad=0.84p pd=3.56u as=0.84p ps=3.56u w=3u l=0.55u
X72 VIN.t215 EAOUT.t109 VOUT.t127 VIN.t30 pfet_06v0 ad=0.84p pd=3.56u as=0.84p ps=3.56u w=3u l=0.55u
X73 VIN.t60 FB FB_BUF.t1 VSS.t72 nfet_05v0 ad=3p pd=11.2u as=3p ps=11.2u w=5u l=0.6u
X74 VIN.t195 EAOUT.t173 VOUT.t109 VIN.t2 pfet_06v0 ad=0.84p pd=3.56u as=0.84p ps=3.56u w=3u l=0.55u
X75 VOUT.t203 EAOUT.t198 VIN.t337 VIN.t28 pfet_06v0 ad=0.84p pd=3.56u as=0.84p ps=3.56u w=3u l=0.55u
X76 VIN.t161 EAOUT.t205 VOUT.t85 VIN.t98 pfet_06v0 ad=0.84p pd=3.56u as=0.84p ps=3.56u w=3u l=0.55u
X77 VOUT.t64 EAOUT.t182 VIN.t135 VIN.t102 pfet_06v0 ad=0.84p pd=3.56u as=0.84p ps=3.56u w=3u l=0.55u
X78 VOUT.t165 EAOUT.t36 VIN.t295 VIN.t187 pfet_06v0 ad=0.84p pd=3.56u as=0.84p ps=3.56u w=3u l=0.55u
X79 VIN.t302 EAOUT.t75 VOUT.t172 VIN.t109 pfet_06v0 ad=0.84p pd=3.56u as=0.84p ps=3.56u w=3u l=0.55u
X80 VOUT.t47 EAOUT.t68 VIN.t101 VIN.t100 pfet_06v0 ad=0.84p pd=3.56u as=0.84p ps=3.56u w=3u l=0.55u
X81 VOUT.t198 EAOUT.t52 VIN.t331 VIN.t171 pfet_06v0 ad=0.84p pd=3.56u as=0.84p ps=3.56u w=3u l=0.55u
X82 VSS.t3 VSS.t4 VSS.t2 ppolyf_u_1k_6p0 r_width=2u r_length=49.33u
X83 VOUT.t66 EAOUT.t84 VIN.t137 VIN.t129 pfet_06v0 ad=0.84p pd=3.56u as=1.8p ps=7.2u w=3u l=0.55u
X84 VIN.t88 EAOUT.t151 VOUT.t41 VIN.t87 pfet_06v0 ad=0.84p pd=3.56u as=0.84p ps=3.56u w=3u l=0.55u
X85 VOUT.t148 EAOUT.t104 VIN.t277 VIN.t48 pfet_06v0 ad=0.84p pd=3.56u as=0.84p ps=3.56u w=3u l=0.55u
X86 VIN.t310 EAOUT.t97 VOUT.t180 VIN.t4 pfet_06v0 ad=0.84p pd=3.56u as=0.84p ps=3.56u w=3u l=0.55u
X87 v2_pmos_core.EAREF.t13 VIN.t229 v2_pmos_core.EAREF.t12 VIN.t230 pfet_06v0 ad=0.35p pd=1.81u as=0 ps=0 w=1.25u l=0.55u
X88 VSS.t1 IREF.t10 a_23576_3894.t11 VSS.t0 nfet_05v0 ad=0.35p pd=1.81u as=0.35p ps=1.81u w=1.25u l=0.6u
X89 a_15692_18710# a_16652_8722# VSS.t90 ppolyf_u_1k_6p0 r_width=2u r_length=49.33u
X90 VIN.t150 EAOUT.t213 VOUT.t77 VIN.t149 pfet_06v0 ad=0.84p pd=3.56u as=0.84p ps=3.56u w=3u l=0.55u
X91 VIN.t308 EAOUT.t159 VOUT.t178 VIN.t120 pfet_06v0 ad=0.84p pd=3.56u as=0.84p ps=3.56u w=3u l=0.55u
X92 VIN.t320 EAOUT.t129 VOUT.t189 VIN.t319 pfet_06v0 ad=0.84p pd=3.56u as=0.84p ps=3.56u w=3u l=0.55u
X93 VIN.t345 EAOUT.t113 VOUT.t211 VIN.t77 pfet_06v0 ad=0.84p pd=3.56u as=0.84p ps=3.56u w=3u l=0.55u
X94 VOUT.t72 EAOUT.t220 VIN.t144 VIN.t85 pfet_06v0 ad=0.84p pd=3.56u as=0.84p ps=3.56u w=3u l=0.55u
X95 VIN.t336 EAOUT.t197 VOUT.t202 VIN.t105 pfet_06v0 ad=0.84p pd=3.56u as=0.84p ps=3.56u w=3u l=0.55u
X96 EAOUT_BUF.t1 a_644_5248.t9 VSS.t69 VSS.t68 nfet_05v0 ad=1.5p pd=6.2u as=1.5p ps=6.2u w=2.5u l=0.6u
X97 VIN.t155 EAOUT.t209 VOUT.t81 VIN.t154 pfet_06v0 ad=0.84p pd=3.56u as=0.84p ps=3.56u w=3u l=0.55u
X98 VIN.t131 EAOUT.t155 VOUT.t61 VIN.t39 pfet_06v0 ad=1.8p pd=7.2u as=0.84p ps=3.56u w=3u l=0.55u
X99 VOUT.t62 EAOUT.t180 VIN.t132 VIN.t118 pfet_06v0 ad=0.84p pd=3.56u as=0.84p ps=3.56u w=3u l=0.55u
X100 VIN.t249 VIN.t247 VIN.t248 VIN.t236 pfet_06v0 ad=1.45p pd=6.16u as=0 ps=0 w=2.5u l=3u
X101 a_13292_18710# VSS.t96 VSS.t95 ppolyf_u_1k_6p0 r_width=2u r_length=49.33u
X102 VIN.t142 EAOUT.t79 VOUT.t70 VIN.t83 pfet_06v0 ad=0.84p pd=3.56u as=0.84p ps=3.56u w=3u l=0.55u
X103 VOUT.t42 EAOUT.t72 VIN.t90 VIN.t89 pfet_06v0 ad=0.84p pd=3.56u as=0.84p ps=3.56u w=3u l=0.55u
X104 VOUT.t161 EAOUT.t56 VIN.t291 VIN.t290 pfet_06v0 ad=0.84p pd=3.56u as=0.84p ps=3.56u w=3u l=0.55u
X105 a_22144_8265.t2 a_22144_8265.t1 VIN.t66 VIN.t65 pfet_06v0 ad=0.7p pd=3.06u as=0.7p ps=3.06u w=2.5u l=3u
X106 VOUT.t21 EAOUT.t18 VIN.t47 VIN.t8 pfet_06v0 ad=0.84p pd=3.56u as=0.84p ps=3.56u w=3u l=0.55u
X107 VIN.t55 EAOUT.t25 VOUT.t25 VIN.t10 pfet_06v0 ad=0.84p pd=3.56u as=0.84p ps=3.56u w=3u l=0.55u
X108 VOUT.t67 EAOUT.t50 VIN.t139 VIN.t138 pfet_06v0 ad=0.84p pd=3.56u as=0.84p ps=3.56u w=3u l=0.55u
X109 EAOUT.t13 VOUT.t132 cap_mim_2f0_m4m5_noshield c_width=27.35u c_length=54.5u
X110 VIN.t263 v2_pmos_core.ENB_5V VIN_BIAS.t2 VIN.t262 pfet_06v0 ad=3p pd=11.2u as=1.4p ps=5.56u w=5u l=0.6u
X111 VIN.t287 EAOUT.t101 VOUT.t158 VIN.t202 pfet_06v0 ad=0.84p pd=3.56u as=0.84p ps=3.56u w=3u l=0.55u
X112 a_12332_18710# a_12812_8722# VSS.t97 ppolyf_u_1k_6p0 r_width=2u r_length=49.33u
X113 VSS.t34 VSS.t32 VSS.t33 VSS.t21 nfet_06v0 ad=2.9p pd=11.16u as=0 ps=0 w=5u l=3u
X114 a_22144_9605.t4 v2_pmos_core.EAREF.t22 EAOUT.t12 VIN.t97 pfet_06v0 ad=0.35p pd=1.81u as=0.35p ps=1.81u w=1.25u l=0.55u
X115 VIN.t222 VIN.t219 VIN.t221 VIN.t220 pfet_06v0 ad=0.725p pd=3.66u as=0 ps=0 w=1.25u l=0.55u
X116 VIN.t341 EAOUT.t133 VOUT.t207 VIN.t169 pfet_06v0 ad=0.84p pd=3.56u as=0.84p ps=3.56u w=3u l=0.55u
X117 VIN.t210 EAOUT.t217 VOUT.t122 VIN.t75 pfet_06v0 ad=0.84p pd=3.56u as=0.84p ps=3.56u w=3u l=0.55u
X118 VIN.t167 EAOUT.t201 VOUT.t89 VIN.t114 pfet_06v0 ad=0.84p pd=3.56u as=0.84p ps=3.56u w=3u l=0.55u
X119 VOUT.t114 EAOUT.t170 VIN.t201 VIN.t15 pfet_06v0 ad=0.84p pd=3.56u as=0.84p ps=3.56u w=3u l=0.55u
X120 VIN.t301 EAOUT.t163 VOUT.t171 VIN.t122 pfet_06v0 ad=0.84p pd=3.56u as=0.84p ps=3.56u w=3u l=0.55u
X121 VOUT.t143 EAOUT.t140 VIN.t272 VIN.t26 pfet_06v0 ad=0.84p pd=3.56u as=0.84p ps=3.56u w=3u l=0.55u
X122 VIN.t69 EAOUT.t117 VOUT.t32 VIN.t32 pfet_06v0 ad=0.84p pd=3.56u as=0.84p ps=3.56u w=3u l=0.55u
X123 IREF.t5 IREF.t4 VSS.t8 VSS.t7 nfet_05v0 ad=0.35p pd=1.81u as=0.35p ps=1.81u w=1.25u l=0.6u
X124 FB_BUF.t0 a_644_5248.t8 VSS.t71 VSS.t70 nfet_05v0 ad=1.5p pd=6.2u as=1.5p ps=6.2u w=2.5u l=0.6u
X125 VSS.t85 VSS.t86 VSS.t84 ppolyf_u_1k_6p0 r_width=2u r_length=49.33u
X126 VIN.t177 EAOUT.t195 VOUT.t95 VIN.t95 pfet_06v0 ad=0.84p pd=3.56u as=0.84p ps=3.56u w=3u l=0.55u
X127 VIN.t192 EAOUT.t179 VOUT.t107 VIN.t30 pfet_06v0 ad=0.84p pd=3.56u as=0.84p ps=3.56u w=3u l=0.55u
X128 VIN.t313 EAOUT.t71 VOUT.t183 VIN.t157 pfet_06v0 ad=0.84p pd=3.56u as=0.84p ps=3.56u w=3u l=0.55u
X129 VIN.t19 EAOUT.t14 EAOUT_BUF.t0 VSS.t9 nfet_05v0 ad=3p pd=11.2u as=3p ps=11.2u w=5u l=0.6u
X130 VOUT.t43 EAOUT.t76 VIN.t92 VIN.t91 pfet_06v0 ad=0.84p pd=3.56u as=0.84p ps=3.56u w=3u l=0.55u
X131 a_644_5248.t5 v2_pmos_core.ENB_5V VSS.t103 VSS.t102 nfet_05v0 ad=0.6p pd=3.2u as=0.6p ps=3.2u w=1u l=0.6u
X132 VOUT.t164 EAOUT.t22 VIN.t294 VIN.t93 pfet_06v0 ad=0.84p pd=3.56u as=0.84p ps=3.56u w=3u l=0.55u
X133 VIN.t25 EAOUT.t29 VOUT.t10 VIN.t24 pfet_06v0 ad=0.84p pd=3.56u as=0.84p ps=3.56u w=3u l=0.55u
X134 a_22144_8265.t8 a_22144_8265.t7 VIN.t256 VIN.t22 pfet_06v0 ad=0.7p pd=3.06u as=0.7p ps=3.06u w=2.5u l=3u
X135 VOUT.t167 EAOUT.t54 VIN.t297 VIN.t175 pfet_06v0 ad=0.84p pd=3.56u as=0.84p ps=3.56u w=3u l=0.55u
X136 VSS.t101 v2_pmos_core.ENB_5V IREF.t8 VSS.t100 nfet_05v0 ad=0.6p pd=3.2u as=0.6p ps=3.2u w=1u l=0.6u
X137 a_13292_18710# a_14252_8722# VSS.t89 ppolyf_u_1k_6p0 r_width=2u r_length=49.33u
X138 VOUT.t6 EAOUT.t38 VIN.t13 VIN.t12 pfet_06v0 ad=0.84p pd=3.56u as=0.84p ps=3.56u w=3u l=0.55u
X139 VSS.t23 VSS.t20 VSS.t22 VSS.t21 nfet_06v0 ad=2.9p pd=11.16u as=0 ps=0 w=5u l=3u
X140 VOUT.t206 EAOUT.t132 VIN.t340 VIN.t17 pfet_06v0 ad=0.84p pd=3.56u as=0.84p ps=3.56u w=3u l=0.55u
X141 a_644_5248.t3 a_644_5248.t2 VSS.t57 VSS.t56 nfet_05v0 ad=1.5p pd=6.2u as=1.5p ps=6.2u w=2.5u l=0.6u
X142 a_22144_8265.t12 VIN.t250 a_22144_8265.t11 VIN.t240 pfet_06v0 ad=1.5p pd=6.2u as=0 ps=0 w=2.5u l=3u
X143 v2_pmos_core.EAREF.t21 v2_pmos_core.EAREF.t20 a_22144_8265.t10 VIN.t104 pfet_06v0 ad=0.35p pd=1.81u as=0.35p ps=1.81u w=1.25u l=0.55u
X144 a_22144_9605.t7 VIN.t225 v2_pmos_core.EAREF.t8 VIN.t226 pfet_06v0 ad=0.35p pd=1.81u as=0.35p ps=1.81u w=1.25u l=0.55u
X145 VIN_BIAS.t0 a_644_5248.t4 VSS.t77 ppolyf_u_1k_6p0 r_width=1u r_length=1.94384m
X146 VIN.t145 EAOUT.t221 VOUT.t73 VIN.t87 pfet_06v0 ad=0.84p pd=3.56u as=0.84p ps=3.56u w=3u l=0.55u
X147 VIN.t207 EAOUT.t167 VOUT.t119 VIN.t4 pfet_06v0 ad=0.84p pd=3.56u as=0.84p ps=3.56u w=3u l=0.55u
X148 VOUT.t50 EAOUT.t144 VIN.t108 VIN.t107 pfet_06v0 ad=0.84p pd=3.56u as=0.84p ps=3.56u w=3u l=0.55u
X149 VIN.t324 EAOUT.t137 VOUT.t193 VIN.t164 pfet_06v0 ad=0.84p pd=3.56u as=0.84p ps=3.56u w=3u l=0.55u
X150 VIN.t282 EAOUT.t121 VOUT.t153 VIN.t73 pfet_06v0 ad=0.84p pd=3.56u as=0.84p ps=3.56u w=3u l=0.55u
X151 VOUT.t0 EAOUT.t90 VIN.t1 VIN.t0 pfet_06v0 ad=0.84p pd=3.56u as=0.84p ps=3.56u w=3u l=0.55u
X152 v2_pmos_core.EAREF.t7 FB a_23576_3894.t5 VSS.t59 nfet_06v0 ad=1.4p pd=5.56u as=1.4p ps=5.56u w=5u l=3u
X153 VOUT.t110 EAOUT.t174 VIN.t196 VIN.t48 pfet_06v0 ad=0.84p pd=3.56u as=0.84p ps=3.56u w=3u l=0.55u
X154 VIN.t347 EAOUT.t115 VOUT.t213 VIN.t183 pfet_06v0 ad=0.84p pd=3.56u as=0.84p ps=3.56u w=3u l=0.55u
X155 VIN.t338 EAOUT.t199 VOUT.t204 VIN.t319 pfet_06v0 ad=0.84p pd=3.56u as=0.84p ps=3.56u w=3u l=0.55u
X156 VIN.t136 EAOUT.t183 VOUT.t65 VIN.t77 pfet_06v0 ad=0.84p pd=3.56u as=0.84p ps=3.56u w=3u l=0.55u
X157 VIN.t128 EAOUT.t153 VOUT.t59 VIN.t127 pfet_06v0 ad=0.84p pd=3.56u as=0.84p ps=3.56u w=3u l=0.55u
X158 VIN.t332 EAOUT.t37 VOUT.t199 VIN.t189 pfet_06v0 ad=0.84p pd=3.56u as=0.84p ps=3.56u w=3u l=0.55u
X159 v2_pmos_core.EAREF.t1 VSS.t35 v2_pmos_core.EAREF.t0 VSS.t25 nfet_06v0 ad=3p pd=11.2u as=0 ps=0 w=5u l=3u
X160 a_22144_9605.t11 VIN.t241 a_22144_9605.t10 VIN.t242 pfet_06v0 ad=0.7p pd=3.06u as=0 ps=0 w=2.5u l=3u
X161 VIN.t21 EAOUT.t21 VOUT.t9 VIN.t20 pfet_06v0 ad=0.84p pd=3.56u as=0.84p ps=3.56u w=3u l=0.55u
X162 VOUT.t20 EAOUT.t46 VIN.t46 VIN.t45 pfet_06v0 ad=0.84p pd=3.56u as=0.84p ps=3.56u w=3u l=0.55u
X163 VIN.t334 EAOUT.t53 VOUT.t200 VIN.t173 pfet_06v0 ad=0.84p pd=3.56u as=0.84p ps=3.56u w=3u l=0.55u
X164 VIN.t3 EAOUT.t33 VOUT.t1 VIN.t2 pfet_06v0 ad=0.84p pd=3.56u as=0.84p ps=3.56u w=3u l=0.55u
X165 VSS.t6 IREF.t2 IREF.t3 VSS.t5 nfet_05v0 ad=0.35p pd=1.81u as=0.35p ps=1.81u w=1.25u l=0.6u
X166 VIN.t35 a_22144_8265.t19 a_22144_9605.t1 VIN.t34 pfet_06v0 ad=0.7p pd=3.06u as=0.7p ps=3.06u w=2.5u l=3u
X167 VOUT.t18 EAOUT.t26 VIN.t42 VIN.t41 pfet_06v0 ad=0.84p pd=3.56u as=0.84p ps=3.56u w=3u l=0.55u
X168 VIN.t99 EAOUT.t65 VOUT.t46 VIN.t98 pfet_06v0 ad=0.84p pd=3.56u as=0.84p ps=3.56u w=3u l=0.55u
X169 VOUT.t13 EAOUT.t58 VIN.t29 VIN.t28 pfet_06v0 ad=0.84p pd=3.56u as=0.84p ps=3.56u w=3u l=0.55u
X170 VOUT.t48 EAOUT.t42 VIN.t103 VIN.t102 pfet_06v0 ad=0.84p pd=3.56u as=0.84p ps=3.56u w=3u l=0.55u
X171 VIN.t265 v2_pmos_core.ENB_5V v2_pmos_core.EN_5V.t1 VIN.t264 pfet_06v0 ad=3p pd=11.2u as=3p ps=11.2u w=5u l=0.6u
X172 VOUT.t58 EAOUT.t152 VIN.t126 VIN.t125 pfet_06v0 ad=0.84p pd=3.56u as=0.84p ps=3.56u w=3u l=0.55u
X173 VOUT.t192 EAOUT.t136 VIN.t323 VIN.t162 pfet_06v0 ad=0.84p pd=3.56u as=0.84p ps=3.56u w=3u l=0.55u
X174 VIN.t278 EAOUT.t105 VOUT.t149 VIN.t197 pfet_06v0 ad=0.84p pd=3.56u as=0.84p ps=3.56u w=3u l=0.55u
X175 VOUT.t181 EAOUT.t98 VIN.t311 VIN.t61 pfet_06v0 ad=0.84p pd=3.56u as=0.84p ps=3.56u w=3u l=0.55u
X176 a_15212_18710# a_14252_8722# VSS.t79 ppolyf_u_1k_6p0 r_width=2u r_length=49.33u
X177 EAOUT.t6 VREF.t2 a_23576_3894.t1 VSS.t59 nfet_06v0 ad=1.4p pd=5.56u as=1.4p ps=5.56u w=5u l=3u
X178 VOUT.t212 EAOUT.t114 VIN.t346 VIN.t63 pfet_06v0 ad=0.84p pd=3.56u as=0.84p ps=3.56u w=3u l=0.55u
X179 VIN.t59 EAOUT.t87 VOUT.t28 VIN.t58 pfet_06v0 ad=0.84p pd=3.56u as=0.84p ps=3.56u w=3u l=0.55u
X180 VSS.t47 VSS.t44 VSS.t46 VSS.t45 nfet_05v0 ad=0.75p pd=3.7u as=0 ps=0 w=1.25u l=0.6u
X181 VIN.t203 EAOUT.t171 VOUT.t115 VIN.t202 pfet_06v0 ad=0.84p pd=3.56u as=0.84p ps=3.56u w=3u l=0.55u
X182 VOUT.t38 EAOUT.t148 VIN.t82 VIN.t6 pfet_06v0 ad=0.84p pd=3.56u as=0.84p ps=3.56u w=3u l=0.55u
X183 VOUT.t26 EAOUT.t94 VIN.t56 VIN.t43 pfet_06v0 ad=0.84p pd=3.56u as=0.84p ps=3.56u w=3u l=0.55u
X184 EAOUT.t2 VSS.t24 EAOUT.t1 VSS.t25 nfet_06v0 ad=3p pd=11.2u as=0 ps=0 w=5u l=3u
X185 VOUT.t82 EAOUT.t210 VIN.t156 VIN.t26 pfet_06v0 ad=0.84p pd=3.56u as=0.84p ps=3.56u w=3u l=0.55u
X186 VIN.t170 EAOUT.t203 VOUT.t91 VIN.t169 pfet_06v0 ad=0.84p pd=3.56u as=0.84p ps=3.56u w=3u l=0.55u
X187 VIN.t72 EAOUT.t119 VOUT.t34 VIN.t71 pfet_06v0 ad=0.84p pd=3.56u as=0.84p ps=3.56u w=3u l=0.55u
X188 VIN.t186 EAOUT.t187 VOUT.t103 VIN.t32 pfet_06v0 ad=0.84p pd=3.56u as=0.84p ps=3.56u w=3u l=0.55u
X189 VOUT.t196 EAOUT.t80 VIN.t327 VIN.t85 pfet_06v0 ad=0.84p pd=3.56u as=0.84p ps=3.56u w=3u l=0.55u
X190 VIN.t330 EAOUT.t73 VOUT.t197 VIN.t149 pfet_06v0 ad=0.84p pd=3.56u as=0.84p ps=3.56u w=3u l=0.55u
X191 VIN.t106 EAOUT.t57 VOUT.t49 VIN.t105 pfet_06v0 ad=0.84p pd=3.56u as=0.84p ps=3.56u w=3u l=0.55u
X192 VIN.t124 a_22144_8265.t16 a_22144_9605.t6 VIN.t79 pfet_06v0 ad=0.7p pd=3.06u as=0.7p ps=3.06u w=2.5u l=3u
X193 VIN.t329 v2_pmos_core.EN_5V.t2 EAOUT.t0 VIN.t328 pfet_06v0 ad=3p pd=11.2u as=3p ps=11.2u w=5u l=0.6u
X194 VIN.t292 EAOUT.t19 VOUT.t162 VIN.t120 pfet_06v0 ad=0.84p pd=3.56u as=0.84p ps=3.56u w=3u l=0.55u
X195 VIN.t246 VIN.t243 VIN.t245 VIN.t244 pfet_06v0 ad=1.45p pd=6.16u as=0 ps=0 w=2.5u l=3u
X196 a_23576_3894.t8 IREF.t13 VSS.t67 VSS.t66 nfet_05v0 ad=0.35p pd=1.81u as=0.35p ps=1.81u w=1.25u l=0.6u
X197 VOUT.t159 EAOUT.t102 VIN.t288 VIN.t193 pfet_06v0 ad=0.84p pd=3.56u as=0.84p ps=3.56u w=3u l=0.55u
X198 VIN.t270 EAOUT.t69 VOUT.t141 VIN.t154 pfet_06v0 ad=0.84p pd=3.56u as=0.84p ps=3.56u w=3u l=0.55u
X199 VIN.t293 EAOUT.t15 VOUT.t163 VIN.t39 pfet_06v0 ad=1.8p pd=7.2u as=0.84p ps=3.56u w=3u l=0.55u
X200 VOUT.t24 EAOUT.t86 VIN.t54 VIN.t53 pfet_06v0 ad=0.84p pd=3.56u as=0.84p ps=3.56u w=3u l=0.55u
X201 a_644_5248.t1 a_644_5248.t0 VSS.t11 VSS.t10 nfet_05v0 ad=1.5p pd=6.2u as=1.5p ps=6.2u w=2.5u l=0.6u
X202 EAOUT.t11 v2_pmos_core.EAREF.t23 a_22144_9605.t2 VIN.t50 pfet_06v0 ad=0.35p pd=1.81u as=0.35p ps=1.81u w=1.25u l=0.55u
X203 VOUT.t208 EAOUT.t134 VIN.t342 VIN.t159 pfet_06v0 ad=0.84p pd=3.56u as=0.84p ps=3.56u w=3u l=0.55u
X204 VOUT.t55 EAOUT.t40 VIN.t119 VIN.t118 pfet_06v0 ad=0.84p pd=3.56u as=0.84p ps=3.56u w=3u l=0.55u
X205 VSS.t105 v2_pmos_core.ENB_5V VOUT.t136 VSS.t104 nfet_05v0 ad=3p pd=11.2u as=3p ps=11.2u w=5u l=0.6u
X206 a_23576_3894.t2 VREF.t0 EAOUT.t8 VSS.t61 nfet_06v0 ad=1.4p pd=5.56u as=1.4p ps=5.56u w=5u l=3u
X207 VOUT.t90 EAOUT.t202 VIN.t168 VIN.t17 pfet_06v0 ad=0.84p pd=3.56u as=0.84p ps=3.56u w=3u l=0.55u
X208 VOUT.t33 EAOUT.t118 VIN.t70 VIN.t36 pfet_06v0 ad=0.84p pd=3.56u as=0.84p ps=3.56u w=3u l=0.55u
X209 VIN.t217 EAOUT.t111 VOUT.t129 VIN.t133 pfet_06v0 ad=0.84p pd=3.56u as=0.84p ps=3.56u w=3u l=0.55u
X210 a_22144_8265.t9 v2_pmos_core.EAREF.t14 v2_pmos_core.EAREF.t15 VIN.t81 pfet_06v0 ad=0.35p pd=1.81u as=0.35p ps=1.81u w=1.25u l=0.55u
X211 VOUT.t190 EAOUT.t130 VIN.t321 VIN.t51 pfet_06v0 ad=0.84p pd=3.56u as=0.84p ps=3.56u w=3u l=0.55u
X212 IREF.t1 IREF.t0 VSS.t81 VSS.t80 nfet_05v0 ad=0.35p pd=1.81u as=0.35p ps=1.81u w=1.25u l=0.6u
X213 VOUT.t78 EAOUT.t214 VIN.t151 VIN.t107 pfet_06v0 ad=0.84p pd=3.56u as=0.84p ps=3.56u w=3u l=0.55u
X214 VIN.t165 EAOUT.t207 VOUT.t87 VIN.t164 pfet_06v0 ad=0.84p pd=3.56u as=0.84p ps=3.56u w=3u l=0.55u
X215 VIN.t181 EAOUT.t191 VOUT.t99 VIN.t73 pfet_06v0 ad=0.84p pd=3.56u as=0.84p ps=3.56u w=3u l=0.55u
X216 VOUT.t168 EAOUT.t160 VIN.t298 VIN.t0 pfet_06v0 ad=0.84p pd=3.56u as=0.84p ps=3.56u w=3u l=0.55u
X217 VSS.t51 VSS.t48 VSS.t50 VSS.t49 nfet_05v0 ad=0.35p pd=1.81u as=0 ps=0 w=1.25u l=0.6u
X218 VIN.t147 EAOUT.t223 VOUT.t75 VIN.t127 pfet_06v0 ad=0.84p pd=3.56u as=0.84p ps=3.56u w=3u l=0.55u
X219 VIN.t184 EAOUT.t185 VOUT.t101 VIN.t183 pfet_06v0 ad=0.84p pd=3.56u as=0.84p ps=3.56u w=3u l=0.55u
X220 VIN.t76 EAOUT.t77 VOUT.t36 VIN.t75 pfet_06v0 ad=0.84p pd=3.56u as=0.84p ps=3.56u w=3u l=0.55u
X221 VIN.t213 EAOUT.t23 VOUT.t125 VIN.t122 pfet_06v0 ad=0.84p pd=3.56u as=0.84p ps=3.56u w=3u l=0.55u
X222 VIN.t115 EAOUT.t61 VOUT.t54 VIN.t114 pfet_06v0 ad=0.84p pd=3.56u as=0.84p ps=3.56u w=3u l=0.55u
X223 VOUT.t7 EAOUT.t30 VIN.t16 VIN.t15 pfet_06v0 ad=0.84p pd=3.56u as=0.84p ps=3.56u w=3u l=0.55u
X224 VIN.t96 EAOUT.t55 VOUT.t45 VIN.t95 pfet_06v0 ad=0.84p pd=3.56u as=0.84p ps=3.56u w=3u l=0.55u
X225 VIN.t31 EAOUT.t39 VOUT.t14 VIN.t30 pfet_06v0 ad=0.84p pd=3.56u as=0.84p ps=3.56u w=3u l=0.55u
X226 a_13772_18710# a_12812_8722# VSS.t73 ppolyf_u_1k_6p0 r_width=2u r_length=49.33u
X227 VOUT.t150 EAOUT.t106 VIN.t279 VIN.t187 pfet_06v0 ad=0.84p pd=3.56u as=0.84p ps=3.56u w=3u l=0.55u
X228 a_23576_3894.t6 FB v2_pmos_core.EAREF.t5 VSS.t61 nfet_06v0 ad=1.4p pd=5.56u as=1.4p ps=5.56u w=5u l=3u
X229 FB_BUF.t2 a_644_5248.t7 VSS.t88 VSS.t87 nfet_05v0 ad=1.5p pd=6.2u as=1.5p ps=6.2u w=2.5u l=0.6u
X230 a_22144_8265.t15 v2_pmos_core.EAREF.t18 v2_pmos_core.EAREF.t19 VIN.t258 pfet_06v0 ad=0.35p pd=1.81u as=0.35p ps=1.81u w=1.25u l=0.55u
X231 v2_pmos_core.EAREF.t17 v2_pmos_core.EAREF.t16 a_22144_8265.t0 VIN.t14 pfet_06v0 ad=0.35p pd=1.81u as=0.35p ps=1.81u w=1.25u l=0.55u
X232 VOUT.t74 EAOUT.t222 VIN.t146 VIN.t125 pfet_06v0 ad=0.84p pd=3.56u as=0.84p ps=3.56u w=3u l=0.55u
X233 VOUT.t112 EAOUT.t168 VIN.t199 VIN.t61 pfet_06v0 ad=0.84p pd=3.56u as=0.84p ps=3.56u w=3u l=0.55u
X234 VIN.t110 EAOUT.t145 VOUT.t51 VIN.t109 pfet_06v0 ad=0.84p pd=3.56u as=0.84p ps=3.56u w=3u l=0.55u
X235 VOUT.t194 EAOUT.t138 VIN.t325 VIN.t100 pfet_06v0 ad=0.84p pd=3.56u as=0.84p ps=3.56u w=3u l=0.55u
X236 VOUT.t154 EAOUT.t122 VIN.t283 VIN.t171 pfet_06v0 ad=0.84p pd=3.56u as=0.84p ps=3.56u w=3u l=0.55u
X237 VOUT.t86 EAOUT.t206 VIN.t163 VIN.t162 pfet_06v0 ad=0.84p pd=3.56u as=0.84p ps=3.56u w=3u l=0.55u
X238 VIN.t198 EAOUT.t175 VOUT.t111 VIN.t197 pfet_06v0 ad=0.84p pd=3.56u as=0.84p ps=3.56u w=3u l=0.55u
X239 VOUT.t123 EAOUT.t218 VIN.t211 VIN.t6 pfet_06v0 ad=0.84p pd=3.56u as=0.84p ps=3.56u w=3u l=0.55u
X240 VOUT.t100 EAOUT.t184 VIN.t182 VIN.t63 pfet_06v0 ad=0.84p pd=3.56u as=0.84p ps=3.56u w=3u l=0.55u
X241 VOUT.t116 EAOUT.t164 VIN.t204 VIN.t43 pfet_06v0 ad=0.84p pd=3.56u as=0.84p ps=3.56u w=3u l=0.55u
X242 VIN.t306 EAOUT.t157 VOUT.t176 VIN.t58 pfet_06v0 ad=0.84p pd=3.56u as=0.84p ps=3.56u w=3u l=0.55u
X243 VOUT.t60 EAOUT.t154 VIN.t130 VIN.t129 pfet_06v0 ad=0.84p pd=3.56u as=1.8p ps=7.2u w=3u l=0.55u
X244 a_22144_9605.t3 a_22144_8265.t17 VIN.t67 VIN.t65 pfet_06v0 ad=0.7p pd=3.06u as=0.7p ps=3.06u w=2.5u l=3u
X245 VIN.t179 EAOUT.t189 VOUT.t97 VIN.t71 pfet_06v0 ad=0.84p pd=3.56u as=0.84p ps=3.56u w=3u l=0.55u
X246 VIN.t304 EAOUT.t81 VOUT.t174 VIN.t87 pfet_06v0 ad=0.84p pd=3.56u as=0.84p ps=3.56u w=3u l=0.55u
X247 VOUT.t22 EAOUT.t34 VIN.t49 VIN.t48 pfet_06v0 ad=0.84p pd=3.56u as=0.84p ps=3.56u w=3u l=0.55u
X248 VIN.t5 EAOUT.t27 VOUT.t2 VIN.t4 pfet_06v0 ad=0.84p pd=3.56u as=0.84p ps=3.56u w=3u l=0.55u
X249 EAOUT_BUF.t2 a_644_5248.t6 VSS.t94 VSS.t93 nfet_05v0 ad=1.5p pd=6.2u as=1.5p ps=6.2u w=2.5u l=0.6u
X250 VIN.t339 EAOUT.t59 VOUT.t205 VIN.t319 pfet_06v0 ad=0.84p pd=3.56u as=0.84p ps=3.56u w=3u l=0.55u
X251 VIN.t78 EAOUT.t43 VOUT.t37 VIN.t77 pfet_06v0 ad=0.84p pd=3.56u as=0.84p ps=3.56u w=3u l=0.55u
X252 EAOUT.t7 VREF.t1 a_23576_3894.t0 VSS.t60 nfet_06v0 ad=1.4p pd=5.56u as=1.4p ps=5.56u w=5u l=3u
X253 a_22144_9605.t5 v2_pmos_core.EAREF.t24 EAOUT.t10 VIN.t113 pfet_06v0 ad=0.35p pd=1.81u as=0.35p ps=1.81u w=1.25u l=0.55u
X254 VSS.t43 VSS.t40 VSS.t42 VSS.t41 nfet_05v0 ad=0.725p pd=3.66u as=0 ps=0 w=1.25u l=0.6u
X255 a_13772_18710# a_14732_8722# VSS.t76 ppolyf_u_1k_6p0 r_width=2u r_length=49.33u
X256 VOUT.t108 EAOUT.t172 VIN.t194 VIN.t193 pfet_06v0 ad=0.84p pd=3.56u as=0.84p ps=3.56u w=3u l=0.55u
X257 VOUT.t175 EAOUT.t156 VIN.t305 VIN.t53 pfet_06v0 ad=0.84p pd=3.56u as=0.84p ps=3.56u w=3u l=0.55u
X258 VIN.t84 EAOUT.t149 VOUT.t39 VIN.t83 pfet_06v0 ad=0.84p pd=3.56u as=0.84p ps=3.56u w=3u l=0.55u
X259 VOUT.t145 EAOUT.t142 VIN.t274 VIN.t89 pfet_06v0 ad=0.84p pd=3.56u as=0.84p ps=3.56u w=3u l=0.55u
X260 VOUT.t186 EAOUT.t126 VIN.t316 VIN.t290 pfet_06v0 ad=0.84p pd=3.56u as=0.84p ps=3.56u w=3u l=0.55u
X261 VIN.t11 EAOUT.t95 VOUT.t5 VIN.t10 pfet_06v0 ad=0.84p pd=3.56u as=0.84p ps=3.56u w=3u l=0.55u
X262 VOUT.t4 EAOUT.t88 VIN.t9 VIN.t8 pfet_06v0 ad=0.84p pd=3.56u as=0.84p ps=3.56u w=3u l=0.55u
X263 VSS.t75 IREF.t6 IREF.t7 VSS.t74 nfet_05v0 ad=0.35p pd=1.81u as=0.35p ps=1.81u w=1.25u l=0.6u
X264 VIN.t117 VSS.t108 v2_pmos_core.ENB_5V VIN.t116 pfet_06v0 ad=0.6p pd=3.2u as=0.6p ps=3.2u w=1u l=40u
X265 VOUT.t84 EAOUT.t204 VIN.t160 VIN.t159 pfet_06v0 ad=0.84p pd=3.56u as=0.84p ps=3.56u w=3u l=0.55u
X266 VIN.t134 EAOUT.t181 VOUT.t63 VIN.t133 pfet_06v0 ad=0.84p pd=3.56u as=0.84p ps=3.56u w=3u l=0.55u
X267 VOUT.t152 EAOUT.t120 VIN.t281 VIN.t138 pfet_06v0 ad=0.84p pd=3.56u as=0.84p ps=3.56u w=3u l=0.55u
X268 VOUT.t96 EAOUT.t188 VIN.t178 VIN.t36 pfet_06v0 ad=0.84p pd=3.56u as=0.84p ps=3.56u w=3u l=0.55u
X269 VOUT.t88 EAOUT.t200 VIN.t166 VIN.t51 pfet_06v0 ad=0.84p pd=3.56u as=0.84p ps=3.56u w=3u l=0.55u
X270 VIN.t208 EAOUT.t31 VOUT.t120 VIN.t202 pfet_06v0 ad=0.84p pd=3.56u as=0.84p ps=3.56u w=3u l=0.55u
X271 VIN_BIAS.t3 IREF.t9 VSS.t106 ppolyf_u_1k_6p0 r_width=1u r_length=0.19609m
X272 v2_pmos_core.EAREF.t4 FB a_23576_3894.t7 VSS.t60 nfet_06v0 ad=1.4p pd=5.56u as=1.4p ps=5.56u w=5u l=3u
X273 VOUT.t11 EAOUT.t70 VIN.t27 VIN.t26 pfet_06v0 ad=0.84p pd=3.56u as=0.84p ps=3.56u w=3u l=0.55u
X274 VIN.t269 EAOUT.t63 VOUT.t140 VIN.t169 pfet_06v0 ad=0.84p pd=3.56u as=0.84p ps=3.56u w=3u l=0.55u
X275 VIN.t33 EAOUT.t47 VOUT.t15 VIN.t32 pfet_06v0 ad=0.84p pd=3.56u as=0.84p ps=3.56u w=3u l=0.55u
X276 VIN.t273 EAOUT.t141 VOUT.t144 VIN.t157 pfet_06v0 ad=0.84p pd=3.56u as=0.84p ps=3.56u w=3u l=0.55u
X277 VSS.t15 VSS.t12 VSS.t14 VSS.t13 nfet_05v0 ad=1.45p pd=6.16u as=0 ps=0 w=2.5u l=0.6u
X278 a_15212_18710# FB VSS.t62 ppolyf_u_1k_6p0 r_width=2u r_length=49.33u
X279 VIN.t238 VIN.t235 VIN.t237 VIN.t236 pfet_06v0 ad=1.45p pd=6.16u as=0 ps=0 w=2.5u l=3u
X280 VOUT.t52 EAOUT.t146 VIN.t111 VIN.t91 pfet_06v0 ad=0.84p pd=3.56u as=0.84p ps=3.56u w=3u l=0.55u
X281 VIN.t312 EAOUT.t99 VOUT.t182 VIN.t24 pfet_06v0 ad=0.84p pd=3.56u as=0.84p ps=3.56u w=3u l=0.55u
X282 VOUT.t44 EAOUT.t92 VIN.t94 VIN.t93 pfet_06v0 ad=0.84p pd=3.56u as=0.84p ps=3.56u w=3u l=0.55u
X283 VOUT.t104 EAOUT.t176 VIN.t188 VIN.t187 pfet_06v0 ad=0.84p pd=3.56u as=0.84p ps=3.56u w=3u l=0.55u
X284 a_22144_8265.t14 VIN.t251 a_22144_8265.t13 VIN.t242 pfet_06v0 ad=0.7p pd=3.06u as=0 ps=0 w=2.5u l=3u
X285 VOUT.t184 EAOUT.t124 VIN.t314 VIN.t175 pfet_06v0 ad=0.84p pd=3.56u as=0.84p ps=3.56u w=3u l=0.55u
X286 VIN.t152 EAOUT.t215 VOUT.t79 VIN.t109 pfet_06v0 ad=0.84p pd=3.56u as=0.84p ps=3.56u w=3u l=0.55u
X287 VOUT.t80 EAOUT.t208 VIN.t153 VIN.t100 pfet_06v0 ad=0.84p pd=3.56u as=0.84p ps=3.56u w=3u l=0.55u
X288 VOUT.t92 EAOUT.t192 VIN.t172 VIN.t171 pfet_06v0 ad=0.84p pd=3.56u as=0.84p ps=3.56u w=3u l=0.55u
X289 VOUT.t126 EAOUT.t108 VIN.t214 VIN.t12 pfet_06v0 ad=0.84p pd=3.56u as=0.84p ps=3.56u w=3u l=0.55u
X290 VIN.t38 a_22144_8265.t5 a_22144_8265.t6 VIN.t34 pfet_06v0 ad=0.7p pd=3.06u as=0.7p ps=3.06u w=2.5u l=3u
X291 VOUT.t71 EAOUT.t224 VIN.t143 VIN.t129 pfet_06v0 ad=0.84p pd=3.56u as=1.8p ps=7.2u w=3u l=0.55u
X292 VSS.t99 v2_pmos_core.ENB_5V v2_pmos_core.EN_5V.t0 VSS.t98 nfet_05v0 ad=3p pd=11.2u as=3p ps=11.2u w=5u l=0.6u
X293 VOUT.t8 EAOUT.t62 VIN.t18 VIN.t17 pfet_06v0 ad=0.84p pd=3.56u as=0.84p ps=3.56u w=3u l=0.55u
X294 v2_pmos_core.EAREF.t3 VSS.t36 v2_pmos_core.EAREF.t2 VSS.t27 nfet_06v0 ad=1.4p pd=5.56u as=0 ps=0 w=5u l=3u
X295 VOUT.t137 EAOUT.t74 VIN.t266 VIN.t107 pfet_06v0 ad=0.84p pd=3.56u as=0.84p ps=3.56u w=3u l=0.55u
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
