victovats/chipalooza3-ldo-gf180/(commit log)

2026-10-30 Prepare schematic for layout: 06v0 devices where L exceeds 05v0 range, 1k poly resistors
    - pfet_05v0 layouts only allow L 0.50-0.545 um and nfet_05v0 0.60-0.695 um, so
    every PMOS and the long NMOS (MIN1/2, MN1) become pfet_06v0 / nfet_06v0.
    Same underlying SPICE model, so simulation results are unchanged.
    - magic supports ppolyf_u_1k_6p0 but not 2k: resistors re-sized to the same
    values (Rref 194.27 um, RrefFB/EA 1944.26 um, R1/R2 345.30/197.24 um).
    - Includes the Oct 9 schematic re-arrangement (netlist-identical).
    - All 45 corners pass; worst-case Iq improves 95.2 -> 90.4 uA.
    [ldo.sch, ldo_levelshift.sch]
2026-10-30 Shut down bias when EN is low; label every result plot with its test conditions
    - MBIASSW disconnects Rref/RrefFB/RrefEA from VIN when EN=0, and
    MPDREF/MPDFB/MPDEA pull the bias nodes to VSS: off current 0.19 nA
    typical, 3.3 nA worst corner (was ~tens of uA through the bias legs)
    - Each plot now has a Test conditions panel (analysis, load type, VIN,
    EN, VREF, CL, corner, metric); new iq.png for quiescent/shutdown current
    - Corner table gains an off-current column; README states how each spec
    is tested
    [ldo.sch]
2026-10-31 Layout in progress: gLayout-based compact layout, merged buffer bias, post-layout PEX and EM/IR
    Schematic
    - Test-buffer bias legs merged: RrefEA / MREFEA now mirror to both MBIASEA
    and MBIASFB (RrefFB, MREFFB, MPDFB removed). All 45 corners re-run:
    identical specs, Iq 62.2 -> 60.0 uA (typ), 90 -> 87 uA (worst)
    - tb_iq also checks the FB_BUF / EAOUT_BUF test buffers
    Layout (layout/build_layout.py, gl_devices.py) - not final
    - Transistors from gLayout, converted to 5/6 V devices (DUALGATE, V5_XTOR)
    - Common-centroid ABBA / BACCAB matched groups with end dummies; R1/R2 as
    7 + 4 interleaved unit resistors
    - 188 x 147 um: signal-flow floorplan, pass device as one 7x30-finger
    block strapp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
    [ldo.sch, tb_iq.sch]
2026-11-09 Add schematic and layout results documents, loop-gain stability analysis
    - simulations/README.md: schematic results (specs, 45 corners, one plot per
    test, loop gain, Cc trade-off, decap and shared-bias checks)
    - layout/README.md: floorplan, matching, DRC/LVS, parasitics, post-layout
    simulation (C and RC) with plots, worst corners, EM/IR, post-layout stability
    - simulations/stability.py (+ --pex): loop broken at the input-pair gate;
    PM >= 70.6 deg schematic / 65.7 deg post-layout with 2 pF on VOUT;
    max VOUT capacitance for 45 deg documented
    - README: repository layout, reproduction steps and open items updated
2026-11-09 Add schematic screenshots to the simulation results README
2026-11-09 Add v2 layout: shared-ring groups, snug floorplan, full routing, PEX and EM/IR
    - core_groups.py / check_groups.py: NMOS and PMOS groups (level shifter merged
    into the shared rings, folded common-centroid input pair and load, dummies)
    - place_v2.py / route_v2.py: snug floorplan, edge-to-edge VIN/VSS metal5 rails,
    wide pass-device straps, Kelvin sense line for the R1/R2 VOUT tap;
    DRC clean, LVS matches uniquely
    - pex/: C and RC extraction, EM/IR check (all within limits)
    - simulations: --layout v1|v2 option; v2 RC post-layout results meet all specs
    (PM 64.4 deg at 2 pF, load regulation 0.27 % typical / 0.75 % worst)
    - Cc resized to 27.35 x 54.5 um to match the core height (schematic up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
    [ldo.sch]
2026-11-09 README: add final-layout results column, refresh open items, link READMEs
    - Main README: v2 RC-extracted results next to the schematic results (typical
    and worst corner), phase-margin row, open items updated to the final layout
    (harness integration, fill exclusion, Iq margin, output capacitance, load
    step), Cc size and v2 files in the repository table
    - layout/v2/README.md: links to the project, simulation and v1 layout READMEs
2026-11-09 Make v2 the main layout in layout/, move the first layout to layout_v1/
    - layout/: the final (v2) layout and its scripts, moved up from layout/v2/,
    plus the device generator and device cells it builds on
    - layout_v1/: the first layout, self-contained (own generator copy); rebuilt
    there to check: identical geometry, LVS match
    - run_sims.py / stability.py: --pex now uses the final layout by default
    (--layout v1 for layout_v1/pex)
    - READMEs: links and reproduce steps updated for the new folders
    - .gitignore: magic .ext extraction files
2026-11-09 Remove helper visualizations from layout/: ratsnest, slot plan, unused floorplans
    Only the final layout, its build scripts and verification stay in layout/.
    place_v2.py defaults to the final (snug) floorplan; its preview PNG is ignored.
